adamforbes92/speedPulserPro/README.md

# SpeedPulser Pro

The SpeedPulser Pro converts a vehicle speed signal — from a gearbox hall sensor, a [Can2Cluster](https://forbes-automotive.com) signal, a CAN bus (ECU / ABS / DSG / UDS), or a GPS module — into a 10 kHz PWM signal that drives a BLDC motor and gives life back to an OEM analog speedometer without a mechanical cable. It can also read engine RPM (hall or CAN) and re-output it as a traditional coil-style ignition signal for a tachometer. It is fully open-source, WiFi-configurable, and calibrated per cluster type so the needle reads accurately across the available speed range of the motor.

It is based on an **ESP32 DevKit V1 (WROOM-32)** and uses a **TY3816B** BLDC motor driven via a native LEDC hardware PWM channel. The PCB is an upgrade for the original SpeedPulser board, with the addition of CAN, GPS and a coil-type RPM output.

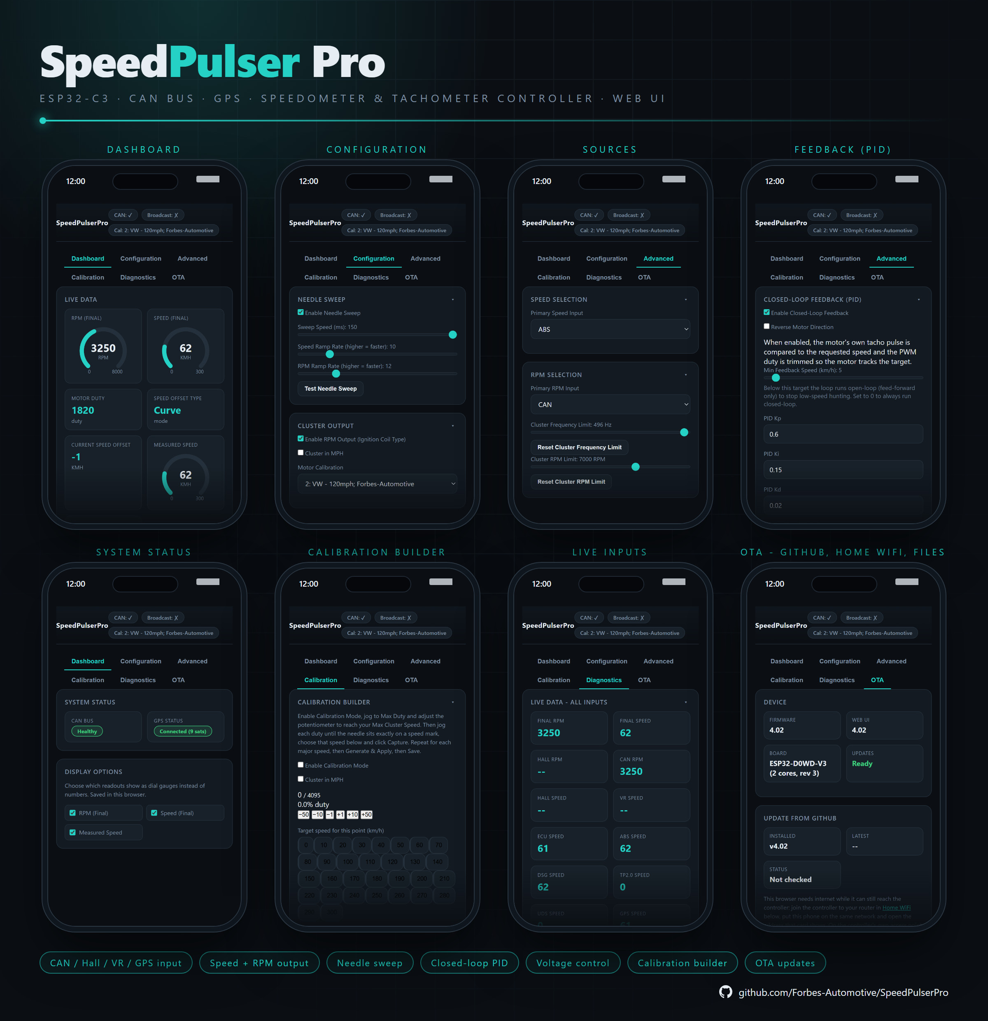
[picture p1: Images/speedPulserProUI.png]
SpeedPulser Pro Web UI — Dashboard, Configuration, Advanced Inputs, Calibration and Diagnostics


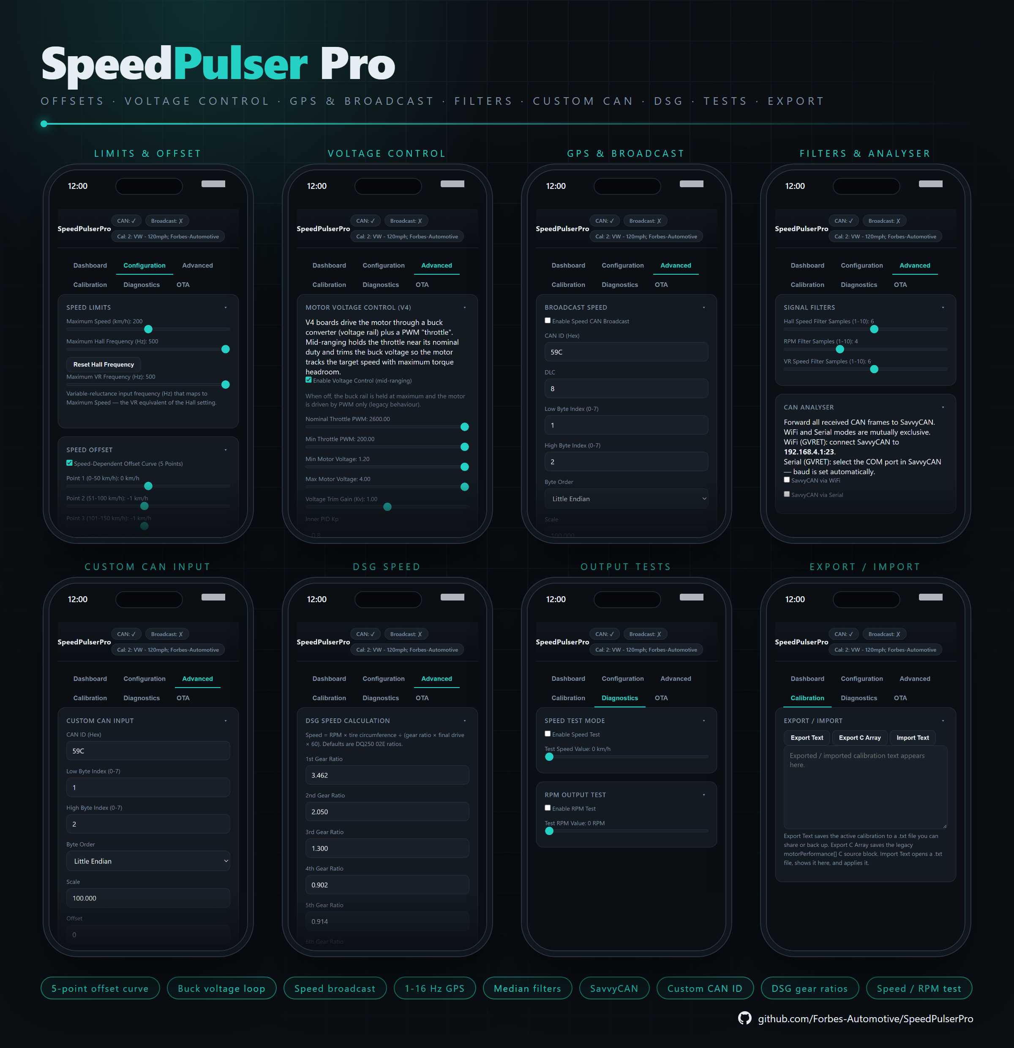
[picture p2: Images/speedPulserProUI-2.png]
SpeedPulser Pro Web UI — limits & offset, voltage control, GPS & broadcast, filters & analyser, custom CAN, DSG speed, output tests and export / import


---

## Features at a Glance

| Feature | Detail |
|---|---|
| Speed input | Hall, ECU (CAN), ABS (CAN), DSG (TP2.0), UDS (CAN), GPS, Custom CAN |
| RPM input | Hall (12 V square wave) or CAN |
| Speedometer output | 10 kHz hardware PWM, 10-bit resolution |
| RPM output | Coil-style square wave (hardware-timer driven) |
| CAN | 500 kbit/s TWAI, full RX/TX, broadcast & SavvyCAN forwarding |
| GPS | u-blox NMEA, 1 / 5 / 10 / 16 Hz user-selectable update rate |
| Calibration profiles | 18 built-in (VW, Ford, Fiat, Merc, Smiths, Opel, VW Bay) |
| Calibration Builder | Custom calibration builder - no coding knowledge required |
| Calibration Curve | Live duty-vs-speed curve with the current operating point on the Dashboard |
| PID Control | Uses the Feedback pin on the motor to ensure speed is maintained, regardless of 'stickyness' |
| WiFi UI | Web app type interface |
| Needle sweep | Full-scale exercise of both needles on power-up (speed + RPM), live-adjustable sweep speed |
| Speed offset | Global fixed offset **or** 5-point speed-dependent curve |
| OTA updates | Update from GitHub or by file upload on the OTA tab; Home Wi‑Fi bridge mode; recovery page if the web UI is ever lost |
| CAN analyzer | Forward live frames to SavvyCAN via WiFi (GVRET) or Serial |
| Power management | Auto WiFi-off + CPU scaling after 1 min idle |
| Remembers settings | All settings stored to ESP32 Preferences (EEPROM) |

---

## Supported Models

| Cluster | Range | Calibration by |
|---|---|---|
| VW MK1 / MK2 Golf | 120 mph | Martin Springell |
| VW MK1 / MK2 Golf | 120 mph | Forbes Automotive |
| VW MK1 / MK2 Golf | 120 mph | Tara |
| VW MK1 / MK2 Golf | 140 mph | Forbes Automotive |
| VW MK1 / MK2 Golf | 160 mph | Forbes Automotive |
| VW MK1 / MK2 Golf | 300 kph (1.8T) | Forbes Automotive |
| VW Bay VDO | 90 mph | Community |
| Ford Escort | 120 mph (var. 1) | Forbes Automotive |
| Ford Escort | 120 mph (var. 2 — Darren) | Community |
| FIAT Uno | 40–160 mph | Forbes Automotive |
| FIAT Uno | 20–110 mph | Forbes Automotive |
| Mercedes W123 | 120 mph | Forbes Automotive |
| Smiths 5/8" | 70 mph | Forbes Automotive |
| Smiths 5/8" | 90 mph | Forbes Automotive |
| Smiths 5/8" | 150 mph | Forbes Automotive |
| Opel Manta A-72 | 200 km/h | Forbes Automotive |

> Users are actively encouraged to submit new models, calibrations, or corrections via GitHub or Discord.

---

## Purchase

Pre-assembled SpeedPulser Pro units are available here: [SpeedPulser Pro — Forbes Automotive](https://forbes-automotive.com/products/speedpulserpro)

---

## More Detailed Instructions

The PDF Installation Guide on GitHub provides full step-by-step hardware fitting instructions.

---

## Hardware Overview

### PCB

The pre-assembled PCB carries three plug-in connectors along its edge plus a 4-pin GPS header:

- **Power / RPM Output** — 3-pin (silkscreen `12v GND MK2RPM`)
- **Motor** — 5-pin (silkscreen `MOTOR`)
- **Inputs / CAN** — 4-pin (silkscreen `RPM Speed CANH CANL`)
- **GPS** — 4-pin pin header (below ESP32)

---

### Power Supply & RPM Output Connector

The three-pin **`12v GND MK2RPM`** connector accepts 12 V battery power and provides the coil-style RPM tach output:

| Pin | Signal | Notes |
|-----|---|---|
| 1 | MK2 RPM Out | Closest to edge of PCB — high-voltage RPM output to the tach |
| 2 | GND | Common ground |
| 3 | PWR_IN (12 V) | Closest to the 5-pin motor connector; connect to ignition-switched 12 V |

> **Note:** The RPM output is intended for clusters expecting a coil-style square wave (e.g. VW MK2 tachometer). Enable it from the **Configuration** tab via the *Use Coil Output (RPM)* checkbox.

> **Legacy clusters & needle jitter:** On some older cluster, the coil-style RPM output can induce a little jitter in the hall inputs due to poor grounding. Fitting a **~500 Ω resistor in series** with the RPM output largely reduces this.

An on-board adjustable **LM2596S** buck converter steps the 12 V supply down to approximately 9 V to power the motor, keeping the motor's operating range and torque within spec across the full speed scale.

---

### Motor Connector

The five-pin **`MOTOR`** connector on the PCB:

| Pin | Signal | Notes |
|-----|---|---|
| 1 | Motor Power | Black — 5–9 V (set via on-board trimmer) |
| 2 | Motor Feedback | For PID Control |
| 3 | Motor Direction | Green — pull to GND to reverse needle direction |
| 4 | Motor Ground | White — motor ground |
| 5 | Motor PWM | 10 kHz PWM from ESP32 (via NPN level-shifter to 4V) |

---

### Inputs / CAN Connector

The four-pin **`RPM Speed CANH CANL`** connector carries both square-wave inputs and the CAN bus:

| Pin | Signal | Notes |
|-----|---|---|
| 1 | RPM In | 12V square-wave RPM input (closest to the blue trimmer) |
| 2 | Speed In | 5V or 12V square-wave speed input (hall sensor or Can2Cluster) |
| 3 | CAN H | CAN bus high |
| 4 | CAN L | CAN bus low (closest to the 5-pin motor connector) |

> **Pull-up / Pull-down jumper:** Different hall sensors require either a pull-up or pull-down resistor. The 2-way jumper marked *SpeedPulser* selects this. If incoming pulses aren't being registered, swap the jumper position. Sensors with an internal resistor can have the jumper removed entirely.

> **CAN termination (`r-term`):** A 120 Ω terminating resistor for the CAN bus is selected by the `r-term` jumper. Leave it fitted if the SpeedPulser Pro is the only device on the bus. Remove it if the bus is already terminated elsewhere.

---

### GPS Connector

The four-pin GPS header accepts any 3.3 V u-blox-compatible NMEA module (e.g. NEO-6M / NEO-M8N):

| Pin | Signal | Notes |
|-----|---|---|
| 1 | 3.3 V | Powered from the ESP32 on-board 3.3 V rail |
| 2 | RX | GPS RX — connect to GPS module TX |
| 3 | TX | GPS TX — connect to GPS module RX |
| 4 | GND | Ground |

The GPS is driven via the ESP32 hardware UART for clean reception at high update rates.

---

### Coupler Installation

Motors are supplied with the coupler pre-fitted; the final drive pin and securing pins are included separately.

1. Remove the motor from the coupler housing.
2. Align the drive pin into the coupler recess and press home — a few light taps should seat it fully.
3. A spare coupler is supplied. Couplers are 3D printed; slight alignment variation is normal. A brief gentle heat application (≤ 100 °C) can encourage a true run.
4. If excessive vibration causes the coupler to loosen, a small drop of super-glue will fix it permanently — confirm it runs true before the glue sets.

---

### Trimming the Drive Shaft

Drive shafts are supplied longer than required. Trim to suit your cluster, typically flush with the motor housing. **Confirm the shaft does not bottom out in the cluster before tightening.**

---

### Fine-Tuning the Coupler

Once the motor is assembled, slide it over the OEM cluster shaft. Check:

- The drive pin engages cleanly
- The motor spins freely by hand
- The pin length is sufficient to engage the cluster but does not prevent the housing from seating fully

Take time here — good fitment minimises noise and extends coupler life.

> Couplers are 3D printed and every motor / housing / cluster pairing wears in slightly differently. Expect to revisit the on-board potentiometer once after a few hours of running so the top-end reading still hits full-scale cleanly.

---

## WiFi & Web Interface

Connect to the **`SpeedPulserPro`** WiFi access point (open network) and navigate to **`192.168.1.1`** or **`speedpulserpro.local`** in a browser.

The interface is a single-page app served from the ESP32's LittleFS flash partition, built on Forbes Automotive's shared dark theme (the same look and status-colour conventions used across OpenHaldex, Can2Cluster, SpeedPulser, can2rpm, the MQB Steering Wheel Controller and AirLift Controller). Settings are applied in real time and saved to EEPROM automatically every 5 seconds. Current firmware version: **5.04**.

**Status colours**, used throughout the Dashboard and Diagnostics tabs:

| Colour | Meaning |
|---|---|
| 🟢 Green | Healthy / connected — CAN traffic present, GPS has a satellite fix, feedback signal detected |
| 🔴 Red | Unhealthy / missing — no CAN traffic, or no GPS module fitted/connected |
| 🟠 Orange | A caveat, not a failure — GPS module is talking but has no satellite fix yet ("Connected (no sats)"), a gauge is showing a **Test Mode** value instead of a real sensor reading, or closed-loop feedback has no motor tacho signal ("N/A" on legacy PCBs) |

### Dashboard Tab

<p align="center">
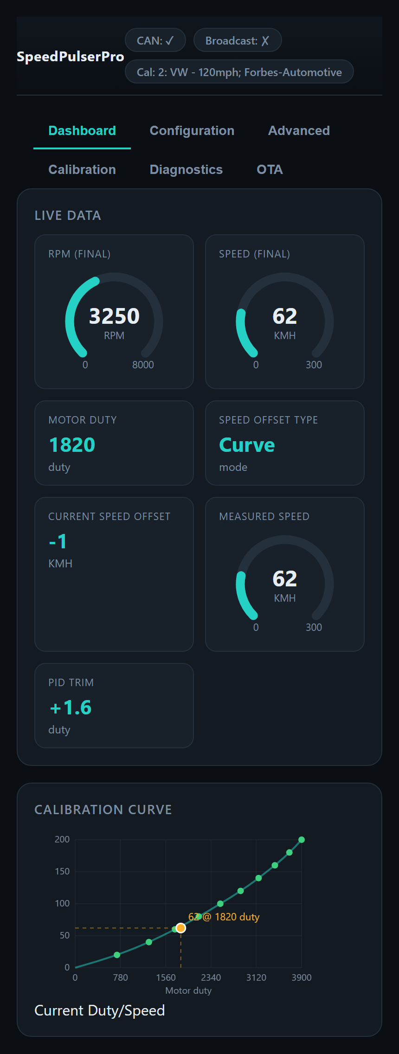
[picture p3: Images/ui-dashboard.png]
Dashboard tab — live data tiles and the calibration curve graph
  
  &nbsp;&nbsp;
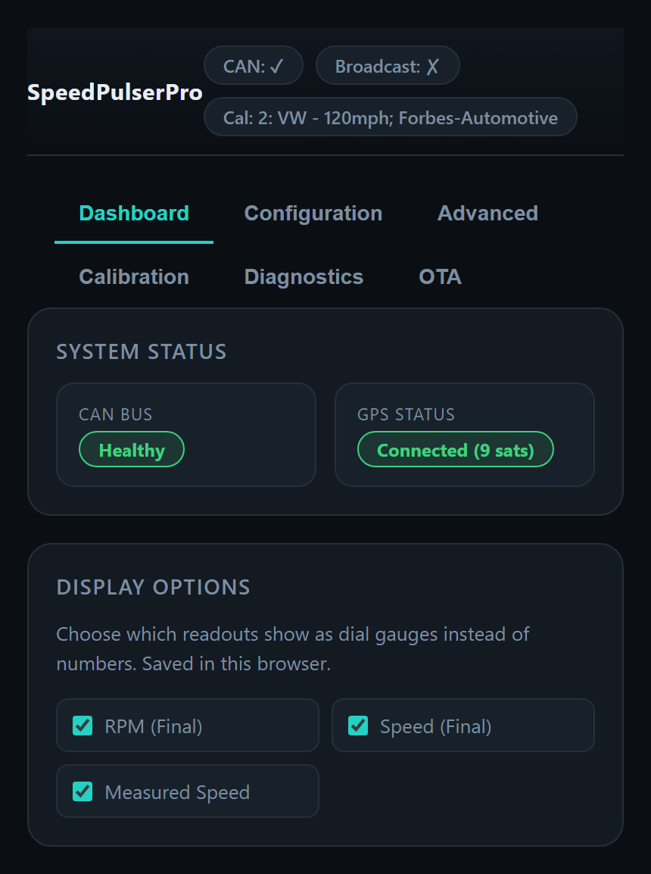
[picture p4: Images/ui-system-status.png]
Dashboard tab — system status pills (CAN, GPS, feedback) and display options
  
</p>

Live read-outs updated automatically:

| Field | Description |
|---|---|
| RPM (Final) | Engine RPM from the active RPM source |
| Speed (Final) | Vehicle speed from the active speed source |
| Motor Duty | PWM duty currently applied to the motor |
| Speed Offset Type | Whether a *Global* or *Curve* offset is active |
| Current Speed Offset | The offset value applied at the current speed |
| Measured Speed | Speed derived from the motor feedback when feedback is enabled |
| PID Trim | Duty correction the feedback loop is currently applying |
| CAN Bus | Live CAN healthy / Not Healthy indicator |
| GPS Status | **Connected (n sats)**, **Not Connected** (module fitted, no serial/fix) or **Not Available** (no GPS module fitted) |

Below the gauges is a **Calibration Curve** graph: a duty-vs-speed trace of the
active calibration with a marker showing the point currently being achieved —
from the active speed source, Speed Test Mode or Calibration Mode.

Header status badges also show **CAN**, **Broadcast** and the active **Calibration** profile.

### Configuration Tab

<p align="center">
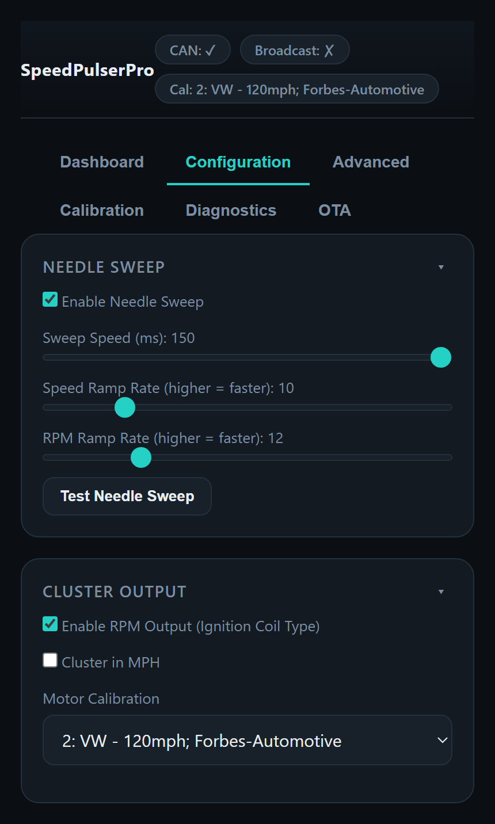
[picture p5: Images/ui-configuration.png]
Configuration tab — needle sweep and cluster output cards
  
  &nbsp;&nbsp;
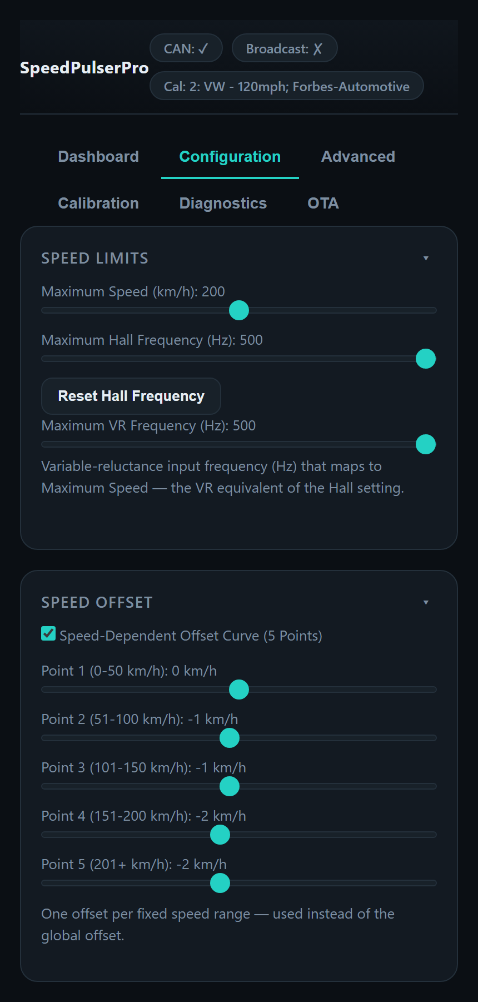
[picture p6: Images/ui-speed-limits.png]
Configuration tab — speed limits (max speed, hall and VR frequency) and the speed offset card with the 5-point curve
  
</p>

| Card | Setting | Description |
|---|---|---|
| **Needle Sweep** | Enable Needle Sweep | Run a full-scale sweep of both needles on power-up |
| | Sweep Speed (ms) | Live slider (0–50) setting the base sweep duration — lower = faster |
| | Speed Ramp Rate | How fast the speedo needle ramps (higher = faster) |
| | RPM Ramp Rate | How fast the tacho needle ramps (higher = faster) |
| | Test Needle Sweep | Trigger a sweep immediately from the browser |
| **Cluster Output** | Use Coil Output (RPM) | Enable the coil-style RPM output on the `MK2RPM` pin |
| **Speed Limits** | Cluster in MPH | Convert the km/h source value to mph before the motor-duty lookup |
| | Motor Calibration | Choose from the built-in cluster calibration profiles |
| | Maximum Speed (km/h) | Upper end of the cluster's speed scale |
| | Maximum Hall Frequency (Hz) | Input frequency that corresponds to Maximum Speed |
| **Speed Offset** | Enable Global Speed Offset | Apply a single fixed offset across the whole range |
| | Positive Offset | Direction of the fixed offset (add or subtract) |
| | Global Speed Offset | Magnitude of the fixed offset |
| | Speed-Dependent Offset Curve | Switch to the 5-point curve (see the Calibration tab) instead of the global offset |

### Advanced Tab

Source selection, tuning and diagnostics:

<p align="center">
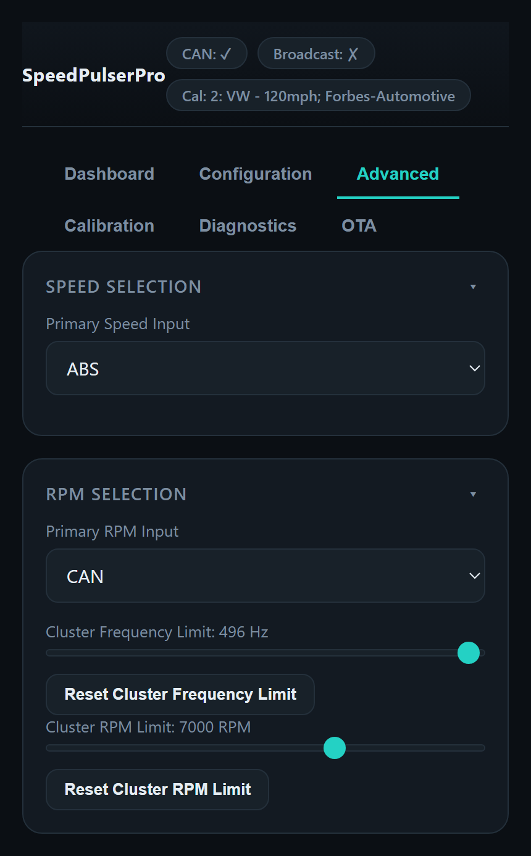
[picture p7: Images/ui-advanced.png]
Advanced tab — speed and RPM source selection
  
  &nbsp;&nbsp;
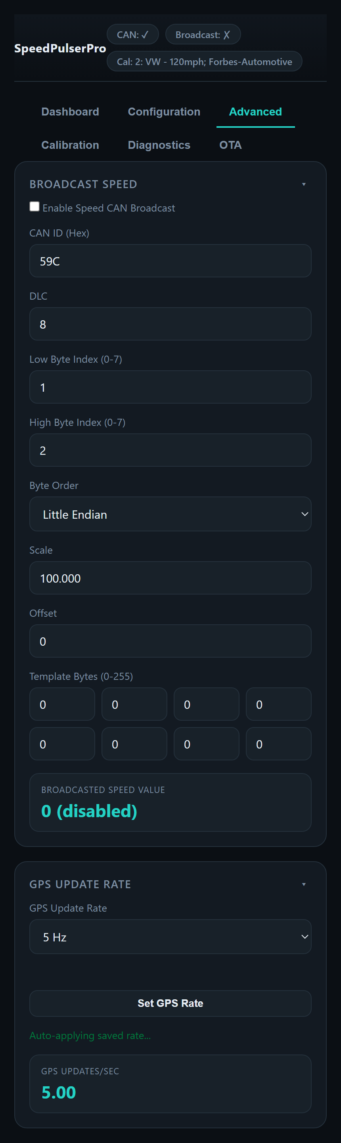
[picture p8: Images/ui-gps.png]
Advanced tab — Broadcast Speed (CAN ID, DLC, byte layout, scale, template bytes) and GPS Update Rate
  
</p>

| Card | Purpose |
|---|---|
| Closed-Loop Feedback (PID) | Enable motor feedback and tune Kp / Ki / Kd |
| Motor Voltage Control (V4) | On V4 boards, enable the mid-ranging buck-voltage loop and set its throttle PWM range, voltage range, trim gain and loop gains |
| Broadcast Speed | Send the final speed onto CAN with user-defined ID, DLC, byte layout, scale & offset bytes |
| GPS Update Rate | Select **1 / 5 / 10 / 16 Hz** and view the live updates-per-second figure |
| Signal Filters | Hall speed, VR speed and RPM running-median sample counts (1–10) |
| CAN Analyser | Forward all received CAN frames to **SavvyCAN** via WiFi (GVRET on `192.168.4.1:23`) or Serial (GVRET) |
| Speed Selection | Primary speed source: Hall / VR (S3) / ECU / ABS / DSG / TP2.0 / UDS / GPS / Custom CAN. Only one is used at a time |
| Custom CAN Input | When *Custom CAN* is selected, define ID, byte indices, endianness, scale & offset |
| DSG Speed Calculation | When *DSG* is selected, the gear ratios, final drives and tyre circumference used to derive speed from RPM and gear |
| RPM Selection | Primary RPM source (Hall or CAN), cluster frequency limit and RPM ceiling |

<p align="center">
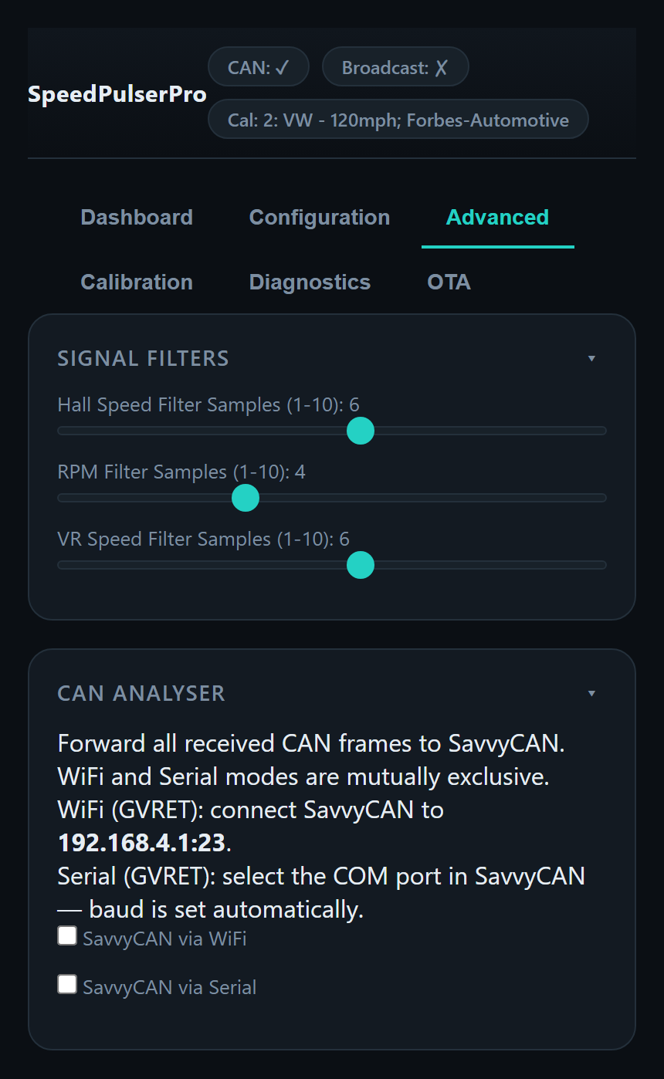
[picture p9: Images/ui-filters-analyser.png]
Advanced tab — Signal Filters (hall, RPM and VR sample counts) and the CAN Analyser SavvyCAN toggles
  
  &nbsp;&nbsp;
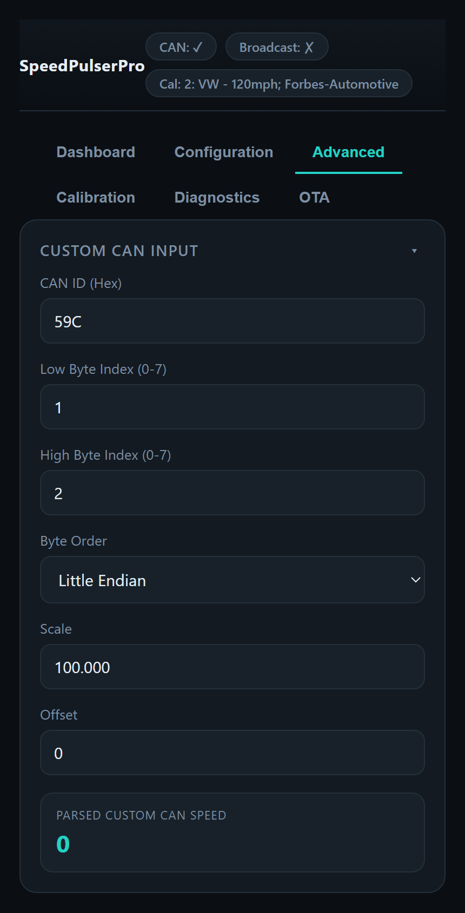
[picture p10: Images/ui-custom-can.png]
Advanced tab — Custom CAN Input: CAN ID, byte indexes, byte order, scale and offset
  
  &nbsp;&nbsp;
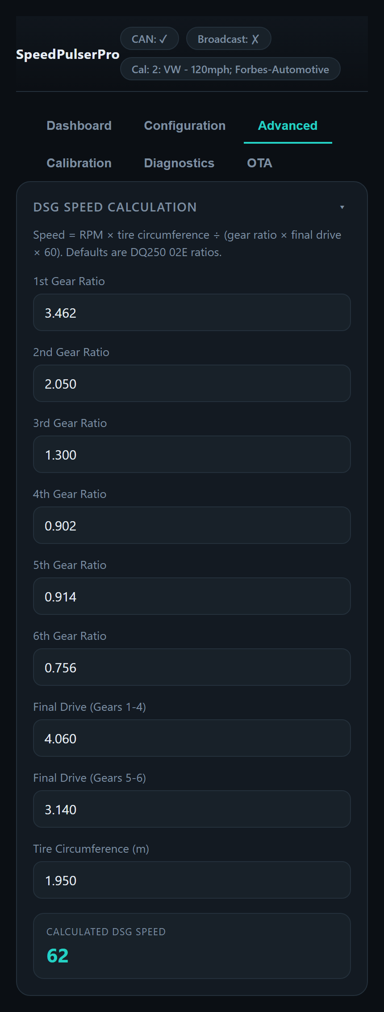
[picture p11: Images/ui-dsg-speed.png]
Advanced tab — DSG Speed Calculation: gear ratios, final drives and tyre circumference
  
</p>

*Advanced: the source selectors (top left), speed broadcast and GPS rate (top right); the filter and analyser cards, and the two cards that appear when Custom CAN or DSG is chosen as the speed source (bottom row).*

#### Closed-Loop Feedback (PID) & Reverse Direction

<p align="center">
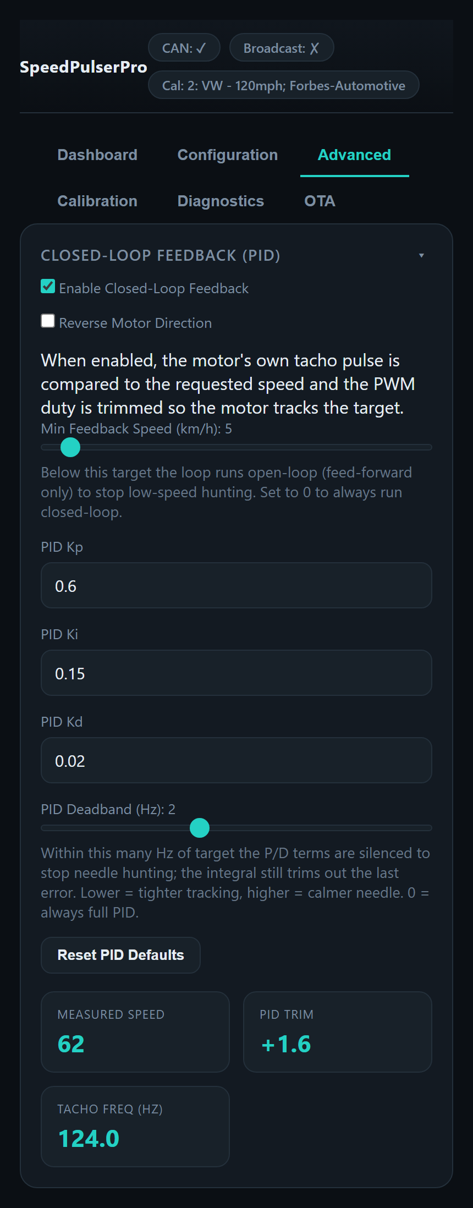
[picture p12: Images/ui-feedback-pid.png]
Advanced tab — Closed-Loop Feedback (PID): enable, reverse direction, min feedback speed, gains and live read-outs
  
  &nbsp;&nbsp;
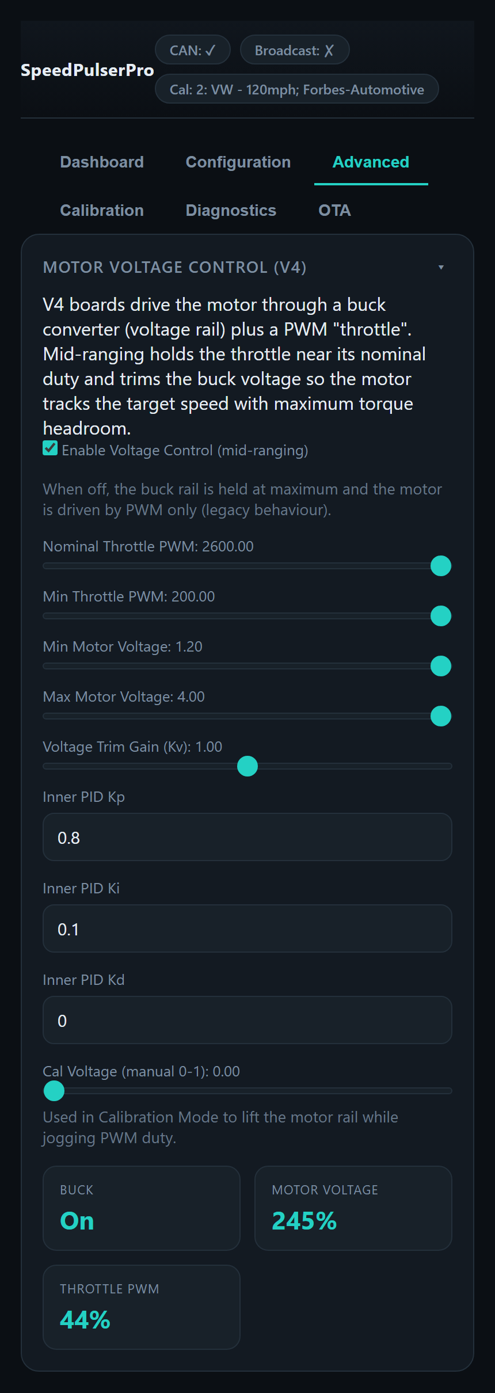
[picture p13: Images/ui-voltage-control.png]
Advanced tab — Motor Voltage Control (V4): enable, nominal / min throttle PWM, min / max motor voltage, trim gain and inner PID gains
  
</p>

The TY3816B motor is normally driven **open-loop** — a calibration table maps speed to a
PWM duty. Closed-loop feedback adds a correction on top of that table: the motor's own
feedback pulse is measured, converted to an equivalent speed, and compared to the requested
speed. A PID controller then trims the duty so the needle tracks the target even as supply
voltage, temperature or coupler friction drift.

- **Enable Closed-Loop Feedback** — turns the loop on. With it off the motor runs purely
  from the calibration table (feed-forward only).
- **Reverse Motor Direction** — flips the commanded rotation for clusters (or coupler
  builds) whose needle sweeps the opposite way. Toggle it if the needle drives backwards
  off the stop.
- **Min Feedback Speed (km/h)** — below this target the loop runs open-loop (feed-forward
  only) to stop low-speed hunting around the motor's dead band. Set to `0` to always run
  closed-loop. 
- **PID Kp / Ki / Kd** — proportional, integral and derivative gains. The defaults
  (`Kp 0.15`, `Ki 1.3`, `Kd 0`) suit the stock motor; *Reset PID Defaults* restores them.
- **Live read-outs** — *Measured Speed*, *PID Trim* (the duty correction currently being
  applied) and *Tacho Freq (Hz)* let you watch the loop settle in real time.

> Feedback is most useful at the top of the scale, where a small voltage sag would
> otherwise leave the needle a few km/h low. Leave *Min Feedback Speed* around 40 km/h so
> the loop only engages once the motor is comfortably out of its dead-band.

**Motor Voltage Control (V4 boards)** — V4 PCBs drive the motor through a buck converter
(voltage rail) as well as the PWM "throttle". With **Enable Voltage Control (mid-ranging)**
on, the fast loop above trims the throttle PWM to hit the target speed while a slow loop
nudges the buck voltage to hold the throttle near its **Nominal Throttle PWM**, keeping
maximum torque headroom. Turn it off and the rail is held at maximum with PWM-only drive
(legacy behaviour).

### Calibration Tab

<p align="center">
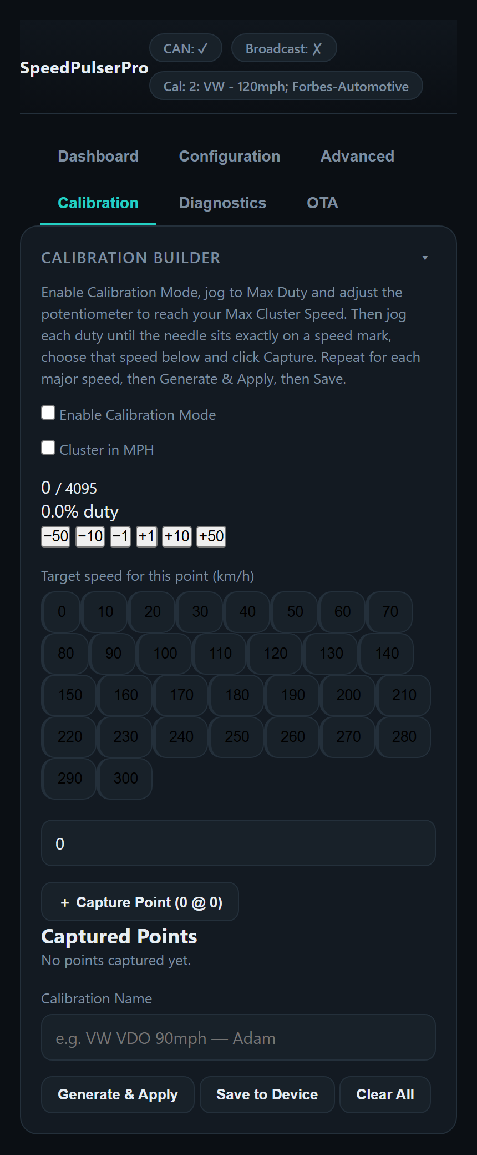
[picture p14: Images/ui-calibration.png]
Calibration tab — the Calibration Builder: calibration mode, duty jog buttons, target speed, capture point, name, Generate & Apply, Save to Device
  
  &nbsp;&nbsp;
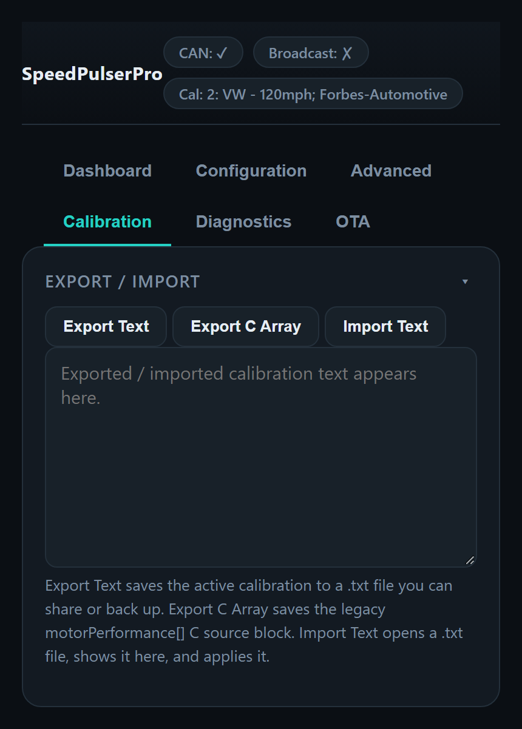
[picture p15: Images/ui-export-import.png]
Calibration tab — Export Text, Export C Array and Import Text
  
</p>

| Card | Purpose |
|---|---|
| Calibration Builder | Build a cluster calibration interactively — change the motor duty, capture a point at each speed, and store the resulting curve without editing source code |
| Export / Import | Export the active calibration to a text block, or upload one to load it |

The **Calibration Builder** is the no-code way to build a custom calibration on the bench.  The other advantage is that it uses a higher range of available duty so available scale is increased.

1. Tick **Enable Calibration Mode** — the motor now follows the big duty read-out instead
   of the speed source.
2. Change the duty to the maximum value (**4096**).  Adjust the trimmer to achieve maximum cluster value.
3. Change the duty with the **−50 / −10 / −1 / +1 / +10 / +50** buttons until the needle sits exactly on a speed mark.
4. Pick that speed from the **Target speed** or type it in and press **Capture Point**. Each capture
   is listed under *Captured Points* and can be removed individually.
5. Repeat across the scale, name the calibration, then **Generate & Apply** to preview it
   live and **Save to Device** to store it. **Export / Import** shares it as a text block.

The **5-Point Speed Offset Curve** is switched on from the *Speed Offset* card on the
Configuration tab. It applies a different trim per speed band instead of a single global
value. Bands are fixed at 0–50 / 51–100 / 101–150 / 151–200 / 201+ km/h, each accepting
±20 km/h.

### Diagnostics Tab

<p align="center">
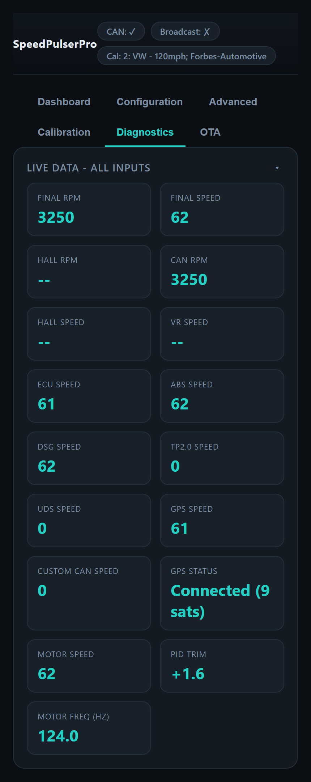
[picture p16: Images/ui-diagnostics.png]
Diagnostics tab — Live Data: every speed and RPM input read separately
  
  &nbsp;&nbsp;
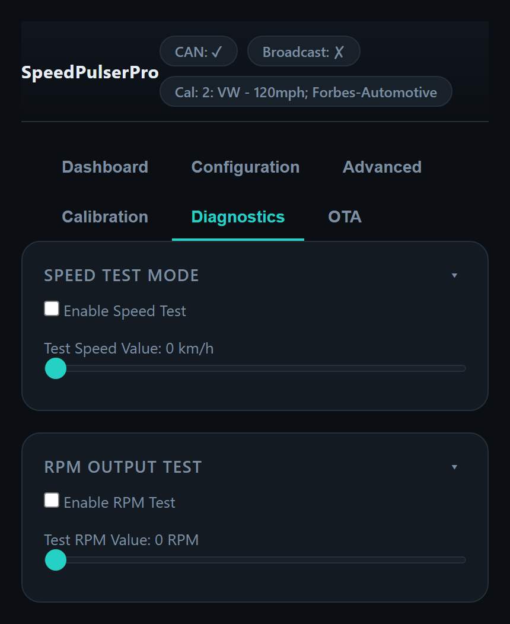
[picture p17: Images/ui-output-tests.png]
Diagnostics tab — Speed Test Mode and RPM Output Test sliders
  
</p>

| Card | Purpose |
|---|---|
| Live Data – All Inputs | Independent read-out for every speed/RPM source (Hall, ECU, ABS, DSG, TP2.0, UDS, GPS, Custom CAN, plus filtered RPM) |
| Speed Test Mode | Drive the speedometer directly to a chosen speed with a slider |
| RPM Output Test | Drive the tachometer directly to a chosen RPM with a slider |

## GPS & Update Rates

The GPS module is driven via the ESP32 hardware UART for reliable reception. SpeedPulser Pro supports user-selectable update rates of **1 Hz, 5 Hz, 10 Hz and 16 Hz**, sent to the module as u-blox UBX rate commands. The selected rate is stored in EEPROM and survives reboots.

### How It Works

1. On boot, the firmware probes the GPS at 9600 baud and 38400 baud and locks onto whichever yields valid checksum-passing NMEA. The u-blox module always boots at 9600, so a re-flash without power-cycling the GPS is handled cleanly.
2. The GPS is left at its boot baud (9600) until satellite lock is acquired.
3. Once satellites are stable for ~20 seconds, the firmware automatically applies the stored update rate. If a rate of 5 Hz or higher is requested, it first issues a `PUBX,41` command to step the module up to 38400 baud (1 Hz uses 9600).
4. The user can also force the rate at any time from the **GPS Update Rate** card on the Advanced tab; the live *GPS Updates/sec* counter confirms what's actually arriving.

### Choosing a Rate

| Rate | When to use |
|---|---|
| 1 Hz | Default; lowest UART load; suitable for casual / cruise display |
| 5 Hz | Smoother needle response in normal driving |
| 10 Hz | Track / spirited driving; very responsive |
| 16 Hz | Maximum responsiveness; some u-blox modules require 38400 baud |

> The update-rate change is blocking on the UART, so the main loop briefly suspends background tasks while the PUBX command is sent — this prevents the CAN RX, speed ISR and AsyncTCP tasks from corrupting the outgoing serial bytes.

---

## Power Management

The firmware includes a **universal reduced-power manager** (`power_manager` — also used in SpeedPulser and Can2Cluster) that activates automatically 1 minute after the last WiFi client disconnects. This cuts current through the on-board linear regulator, directly reducing its heat output — important for long ignition-on times.

**What changes when idle:**

| Action | Saving |
|---|---|
| WiFi radio off | ~80–120 mA average (single biggest saving) |
| CPU: 240 MHz → 80 MHz | Moderate reduction in active current |
| Bluetooth controller released at boot | ~60 KB RAM freed; small idle current saving |
| WiFi modem-sleep while clients are connected | Minor saving without losing connectivity |
| Reduced WiFi TX power | Adequate for in-car range; further small saving |
| Onboard LED off at boot | Tiny but persistent saving |

**Waking back up:**  
As soon as a device reconnects to the WiFi AP, full power is restored automatically — the radio comes back up, the CPU returns to 240 MHz, and the web server resumes. A power-cycle (ignition off/on) will also restore WiFi.

> The ESP32 DevKit V1 (WROOM-32) runs at 240 MHz; the power manager auto-detects this at compile time and adjusts accordingly. On ESP32-C3 / S2 variants the active clock caps at 160 MHz.

---

## Calibration — How It Works

### The Legacy Calibration Array

Each calibration profile is a **386-element `uint16_t` array** stored in flash (`PROGMEM`). The **array index** represents speed in km/h (0–385) and the **array value** is the 10-bit PWM duty cycle (0–1023) that drives the motor to produce the corresponding reading on that cluster.

```
index   0  →  duty   0   (motor off / dead band)
index  50  →  duty  ~60  (motor at ~50 km/h cluster reading)
index 120  →  duty ~130  (motor at ~120 km/h cluster reading)
  ...
index 200  →  duty ~195  (motor at full scale for a 200 km/h cluster)
```

Values near index 0 are `0` — the motor's dead band where it will not yet turn. Values plateau near the top because the cluster needle is at full deflection.

> The Calibration Builder now supports a larger duty range and finer control is now available.  Legacy speed arrays are already produced so cannot be revisited.  Building your own may yield better results!

### Signal Processing 

```
Source (Hall / ECU / ABS / DSG / TP2.0 / UDS / GPS / Custom CAN)
    │
    ▼  ISR (windowed capture) / TWAI RX / GPS parser
    Hall / VR / RPM inputs accumulate each edge interval + count, rejecting
    edges closer than half a period at that input's full scale as electrical
    noise; other sources arrive in km/h
    │
    ▼  speedControlTask  (once per loop)
    For Hall: frequency = intervals ÷ summed interval time (true average over the
    window), then map(frequency, 0, maxFreqHall, 0, maxSpeed) → km/h
    For other sources: speed already in km/h
    │
    ▼  RunningMedian filter  (averageFilterHall samples, default 6)
    Smoothed median speed value
    │
    ▼  Max Speed check
    Above Max Speed for a moment: hold the last good speed (spike);
    above it for 0.5 s: park at Max Speed
    │
    ▼  applyConfiguredSpeedOffset()
    Speed ± global offset  OR  speed ± curve offset for that band
    │
    ▼  Optional: × 0.621371  if "Cluster in MPH" is enabled
    │
    ▼  findClosestMatch()
    Scans motorPerformance[] for the closest matching speed value
    Returns the array index = 10-bit duty cycle
    At or below the array's lowest speed the motor stays off
    │
    ▼  setMotorDuty()  — native LEDC IDF driver, 10 kHz
    Motor PWM output on GPIO 21
```

> **Default hall-sensor scaling:** 1 Hz = 1 km/h. This matches 02J / 02M gearbox sensors used in most VW/Audi applications. Adjust `maxFreqHall` and `maxSpeed` together if your sensor has a different ratio (e.g. set both to 160 for a sensor that outputs 160 Hz at 160 km/h).

> **Windowed frequency capture:** The hall, VR and RPM inputs no longer derive their reading from a single edge-to-edge period — which could turn tone-wheel / tooth-spacing jitter straight into a jumpy needle. Instead each ISR accumulates the edge intervals and the task averages them once per window, and edges closer than half a period at that input's full scale (Max Hall Frequency / Max VR Frequency / Cluster Frequency Limit, never above 1 kHz) are rejected so ignition-coil EMI can't be mistaken for a valid signal.

> [!NOTE]
> **Lowest speed shown:** each legacy calibration array has a lowest speed the motor can hold (the default array starts at 24 km/h). At or below it the motor is switched off and the needle rests on zero, so low test speeds on the bench may not move the needle. On the S3 board, Voltage Control with a drive calibration that includes a low mark reaches much slower speeds.

### Reading a Legacy Calibration Array

To check what duty a profile produces at a given speed, index directly:

```cpp
// Direct lookup — returns the 10-bit duty for 80 km/h on the active profile
uint16_t duty = motorPerformance[80];
```

`findClosestMatch()` does the inverse: given a target speed value, it walks the array to find the entry whose **value** is closest to the target and returns the **index** as the duty cycle. This gracefully handles calibration arrays that are not perfectly monotone.

---

## Speed Offset

Two offset modes are available and are configured from the **Configuration** and **Calibration** tabs respectively.

**Global Offset** (default)  
A single fixed value is added to or subtracted from every speed reading before the calibration lookup. Useful for correcting a systematic bias across the whole scale caused by motor preload or cluster wear.

**5-Point Curve**  
Five independent offsets replace the global offset when enabled. This corrects clusters whose response is non-linear and cannot be fixed by a single constant.

| Point | Speed band |
|---|---|
| 1 | 0 – 50 km/h |
| 2 | 51 – 100 km/h |
| 3 | 101 – 150 km/h |
| 4 | 151 – 200 km/h |
| 5 | 201+ km/h |

Each point accepts ±20 km/h. Enable the *Speed-Dependent Offset Curve* checkbox on the Calibration tab to activate.

---

## CAN Bus

The SpeedPulser Pro runs the ESP32 TWAI controller at **500 kbit/s** with all-pass filtering, so any frame on the bus is available to the firmware.

### Built-in Decoders

| Source | Frames used | Output |
|---|---|---|
| ECU (VAG) | `MOTOR1` engine RPM, `MOTOR2` speed, `MOTOR5/6` EML/EPC/park | `vehicleRPMCAN`, `ecuSpeed` |
| ABS (VAG) | `BRAKES3` wheel-derived speed | `absSpeed` |
| DSG / Gear lever | `mWaehlhebel_1`, `gearLever` | Selected gear, reverse flag |
| DSG (TP2.0) | Channel setup → speed PID | `tp20Speed` |
| Generic | UDS read (0x22) speed PID | `udsSpeed` |
| Custom CAN | User-defined ID + byte layout | `vehicleSpeedCAN` |

Pick the source from the **Speed Selection** drop-down on the Advanced tab.

### Broadcasting Speed

The final processed speed (after offset / MPH conversion) can be re-emitted onto CAN for downstream devices (e.g. cluster mods, head units). Configure the CAN ID, DLC, low/high byte indices, endianness, scale, offset and any template bytes from the **Broadcast Speed** card.

### SavvyCAN Forwarding

Every received frame can be forwarded to **SavvyCAN** for live capture:

- **WiFi mode** — GVRET protocol on TCP port `192.168.4.1:23`.
- **Serial mode** — GVRET protocol on USB-CDC.

The two modes are mutually exclusive and can be toggled from the CAN Analyzer card.

---

### Over-the-Air Updates

Everything happens on the **OTA** tab; USB is only needed for the very first install, or if the web interface is ever lost.

- **Update from GitHub** — press **Check for updates**. The page reads the release list from [`adamforbes92/speedPulserPro`](https://github.com/adamforbes92/speedPulserPro) (`Releases/releases.json` plus the `V…` folders), shows *Installed* vs. *Latest* (older and beta releases sit behind a tick-box, for rolling back), then installs the selected version in six tracked steps: download and flash the web UI, verify it, download and flash the firmware, reboot. The browser needs internet *while it can still reach the controller* — join the controller to your router in the **Home WiFi (Bridge Mode)** card, put the phone on the same network and open the address the card shows (`http://speedpulserpro.local/` works there too). On the controller's own access point alone most phones drop mobile data.
- **Home WiFi (Bridge Mode)** — the controller joins a home or garage network as a station alongside its own access point. Scan or type the network name, save, and once it shows *Connected* the controller is reachable from that network as well. It tries hard for 20 s after boot, then once every 5 minutes, so a saved network can't disturb the access point when the car is parked away from home.
- **Update from Files** — no internet needed: download `littlefs.bin` and `firmware.bin` from the newest `Releases/V…/` folder and upload them here, **Filesystem** (web UI) first, then **Firmware**. The device reboots after the firmware.

Every upload is size-checked, and a filesystem image is verified by mounting it before the device reports success — a failed filesystem upload is wiped rather than left half-written. If the web interface is ever missing (a filesystem update that stopped part-way), the controller serves a **recovery page** at its address with the same two uploads and partition diagnostics, so it is never a USB job. Web assets are served `no-cache`, so a new UI is never hidden behind a stale copy in the phone's browser. `GET /api/ota/info` reports the firmware and web UI versions shown at the top of the tab; `GET /api/ota/check` gates updates on the device being in a safe state.

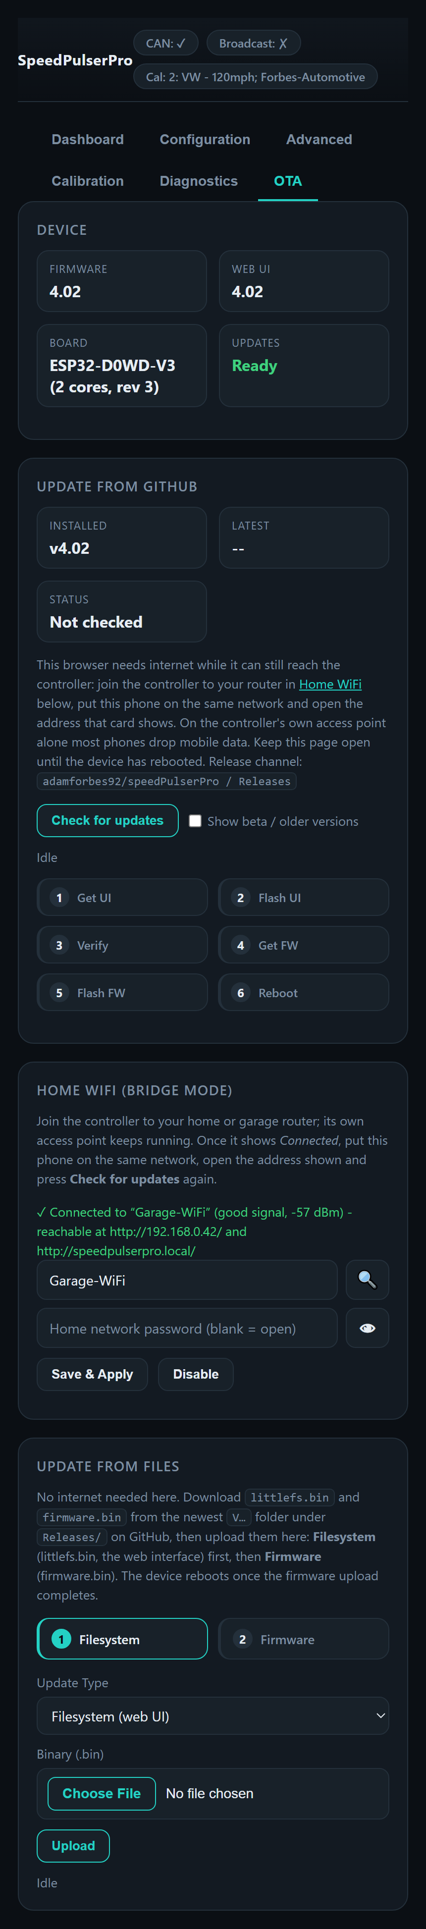
[picture p18: Images/ui-ota.png]
OTA tab — Update from GitHub, Home WiFi bridge mode and Update from Files


---

## Technical Reference

### Pin Assignments (ESP32 DevKit V1)

| GPIO | Function |
|---|---|
| 2  | Onboard LED |
| 13 | GPS TX (ESP → module RX) |
| 14 | GPS RX (ESP ← module TX) |
| 16 | TWAI / CAN TX |
| 17 | TWAI / CAN RX |
| 18 | RPM hall input (falling-edge interrupt) |
| 19 | Motor Direction |
| 21 | Motor PWM output (LEDC, stepped to 5 V via NPN transistor) |
| 22 | Coil-style RPM output (hardware timer) |
| 23 | Motor Feedback |
| 26 | Speed hall input (falling-edge interrupt) |

### PWM Parameters

| Parameter | Value |
|---|---|
| Frequency | 10 kHz |
| Resolution | 10-bit (0–1023) |
| Driver | Native ESP-IDF `ledc_set_duty` / `ledc_update_duty` |

### CAN / TWAI

| Parameter | Value |
|---|---|
| Baud | 500 kbit/s |
| Mode | Normal, accept-all filter |
| RX queue | 256 frames |
| TX queue | 16 frames |

### FreeRTOS Tasks

| Task | Purpose |
|---|---|
| `taskCANRx` | TWAI receive + decoder + SavvyCAN forwarder |
| `taskWriteEEP` | Persist Preferences (5 000 ms) |
| `taskUpdateUI` | Push live values to the web UI (200 ms) |
| `taskParseGPS` | Continuous TinyGPS++ parse |
| `taskParseDSG` | DSG / gear ratio decode |
| `taskProcessSpeed` | Hall averaging, source selection, offset, duty lookup |
| `taskProcessRPM` | RPM source selection and output drive |
| `taskBroadcastSpeed` | Periodic CAN broadcast of final speed |
| `taskTP20` / `taskUDS` | Transport-protocol speed pollers |

### PlatformIO Dependencies

| Library | Purpose |
|---|---|
| `mathieucarbou/ESPAsyncWebServer` | Async web server (ESP-IDF 5.x compatible fork) |
| `mathieucarbou/AsyncTCP` | Underlying TCP for AsyncWebServer |
| `bblanchon/ArduinoJson` | JSON serialisation for REST API |
| `RobTillaart/RunningMedian` | Median filter for speed/RPM smoothing |
| `mikalhart/TinyGPSPlus` | NMEA parsing |
| `plerup/espsoftwareserial` | Legacy software-UART fallback |

Platform: `pioarduino/platform-espressif32` 54.03.20 (Arduino-ESP32 3.x / ESP-IDF 5.x)

---

## Disclaimer

The SpeedPulser Pro drives an analog speedometer for display purposes. It should always be assumed that the reading is approximate — Forbes Automotive accepts no responsibility for any speed-related incident arising from its use.

---

## Version History

| Version | Summary |
|---|---|
| V1.01 | Initial release — used SpeedPulser and Can2Cluster as a base |
| V1.02 | Confirmed WiFi and RPM working |
| V1.03 | Board revision — EasyEDA, ground planes, separate Speed / RPM pull-to-ground inputs, ECU RPM repurposed pin |
| V1.04 | "Cannot find" speed → set to zero; low-speed fixes |
| V1.05 | Hall-type RPM in WiFi UI; on-the-fly calibration changes; read EEP at startup |
| V1.06 | New calibrations; removed `setTxPower` (caused WiFi drop on speed change) |
| V1.07 | Speed-input selection in WiFi; UI tidy-up |
| V1.08 | Calibration page |
| V2.00 | PlatformIO port; UDS support for DSG speed reading |
| V2.01 | GPS speed reading; CAN speed broadcasting; configurable & persistent GPS update rate |
| V2.10 | Linearised needle sweep; Tara 120 mph calibration |
| V2.20 | SavvyCAN analyzer; "Cluster in MPH" conversion option |
| V2.30 | RPM / speed task pacing tuned so GPS has room to update |
| V2.40 | GPS moved to hardware `HardwareSerial` UART for faster, cleaner reception |
| V2.50 | Universal power-management module (WiFi-off + CPU scaling after 1 min idle); GPS auto-baud probe on boot; GPS update-rate auto-apply after satellite stability |
| V3.00 | Closed-loop motor feedback (PID) — measures the motor tacho and trims PWM duty so the needle holds under load |
| V3.01 | Live calibration-curve graph on the Dashboard (duty-vs-speed trace + achieved-point marker); Dashboard mirrors the standard SpeedPulser (Motor Duty / Measured Speed / PID Trim) |
| V3.02 | Live Sweep Speed slider; needle sweep rewritten to drive both needles to full deflection over a bounded time with independent Speed/RPM ramp rates (drops the Linearise control); shared `ota_manager` OTA module + reworked OTA tab; three-state GPS status; Speed Test Mode moved to the Diagnostics tab |
| V3.03 | Custom calibrations now remember the cluster unit they were captured in and the device auto-enables "Cluster in MPH" whenever an MPH cal becomes the active calibration |
| V3.04 | Closed-loop feedback is sense-check for legacy PCBs without the motor-feedback circuit |
| V4.00.0 | Voltage-control hardware support (VR input) |
| V4.01.0 | Adopted Forbes Automotive's shared Ignitron dark theme, Wi‑Fi AP/mDNS manager (`speedpulserpro.local`) and the two-step `ota_manager` firmware/filesystem OTA module, common across the ESP32 product line |
| V4.02 | OTA overhaul: uploads that complete, verified filesystem updates with a recovery page, "Update from GitHub" and a Home WiFi (bridge mode) card |
| V5.00 | ESP32-S3 board (rev6): one codebase for DevKit and S3, buck voltage control with Test Board, VR speed input, switchable speed-input bias |
| V5.01 | S3 drive calibration: up to 10 captured marks set the motor drive (rail x PWM), with an optional gentle feedback trim; voltage calibration export / import |
| V5.02 | RPM input passes through to the tach 1:1 (was ~30 RPM low); fractional-Hz RPM output; glitch filter scaled per input, so 6/8-cyl RPM above 333 Hz no longer reads half; RPM Filter Samples = 1 no longer outputs 0 RPM |
| V5.03 | Picking a speed source switches the others off (Custom CAN left TP2.0 on), and the page always shows the source really in use; a speed above Max Speed for 0.5 s parks the needle at Max Speed instead of 0; the Positive Offset tick now saves across restarts |
| V5.04 | MQB DSG speed over UDS corrected (shared DSG speed code, ported from the Can2Cluster firmware reverse-engineering): reads DID `0x100A` "Vehicle speed from transmission" on the DSG's own IDs `0x7E1/0x7E9`, 16-bit little-endian signed, km/h = raw/10, replacing a placeholder (`0x0101`, /100). PQ DSG speed (TP2.0, raw/3) confirmed correct and unchanged |
