adamforbes92/speedPulserPro/Images/gpsConnector.png

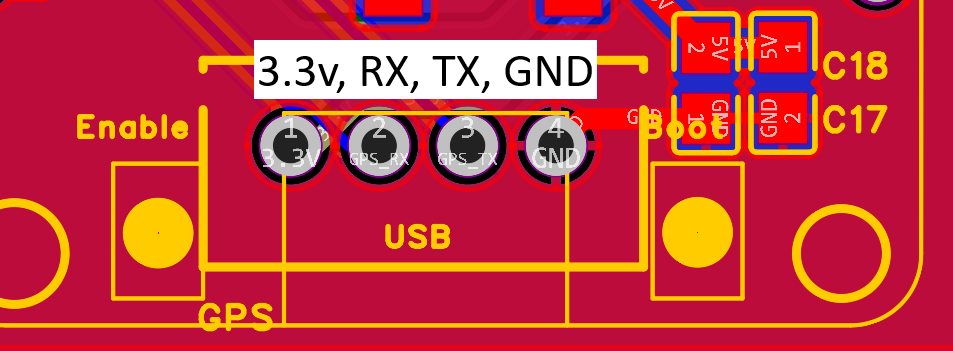
Images/gpsConnector.png
