adamforbes92/speedPulserPro/PlatformIO/include/SpeedPulserPro_config.h

#define CONFIG_H
#include "Arduino.h"
#include <WiFi.h>
#include <LittleFS.h>
#include <ESPAsyncWebServer.h>
#include "SpeedPulserPro_board.h" // SPP_BOARD_DEVKIT / SPP_BOARD_S3 + SPP_HAS_* feature flags
#define baudSerial 115200
#define enableDebug 1        // ** MASTER ** 0 = silence ALL serial debug
#define debugSys     1       // [SYS]   boot / tasks / general / 1 Hz telemetry
#define debugPower   1       // [PWR]   power_manager (WiFi-off / CPU scaling)
#define debugWifi    1       // [WiFi]  soft-AP, web server, REST, OTA, LittleFS
#define debugIO      1       // [IO]    hardware bring-up (LED / PWM / interrupts)
#define debugEEP     1       // [EEP]   Preferences read / write
#define debugCAN     1       // [CAN]   TWAI driver + chassis CAN RX
#define debugGPS     1       // [GPS]   GPS init / baud / rate / RX
#define debugSpeed   1       // [SPD]   speed processing + incoming pulses
#define debugRPM     1       // [RPM]   RPM processing + output
#define debugDSG     1       // [DSG]   DSG gear + speed
#define debugUDS     1       // [UDS]   UDS / TP2.0 diagnostic speed
#define debugSavvy   1       // [SAVVY] SavvyCAN GVRET bridge
#define debugCtrl    1       // [CTRL]  speed offset / motor calibration
#define debugFB      1       // [FB]    closed-loop feedback (PID)
#define serialDebug         (enableDebug && debugSys)
#define serialDebugIncoming (enableDebug && debugSpeed)
#define serialDebugWifi     (enableDebug && debugWifi)
#define serialDebugEEP      (enableDebug && debugEEP)
#define serialDebugGPS      (enableDebug && debugGPS)
#define ChassisCANDebug     (enableDebug && debugCAN)
#define eepRefresh 5000
#define labelRefresh 200
#define wifiDisable 60000
#define wifiHostName "SpeedPulserPro"
#define FW_VERSION "5.04"
#define incomingType 0
#define DEFAULT_AVERAGE_FILTER_HALL 6
#define DEFAULT_AVERAGE_FILTER_RPM 6
#define durationReset 1500
#define SPEED_OVER_RANGE_LOOPS 10 // speed task loops (10 x 50 ms = 0.5 s) a source must stay above Max Speed before the needle parks at Max Speed
#if SPP_BOARD_S3
#define pinMotorOutput 10       // pad 18 ESP_MOTOR      -> U11 SN74LVC1G14 -> MOTOR_OUT (PWM, LEDC)
#define pinRPMOutput 9          // pad 17 ESP_MK2RPM     -> R24 330R -> Q1 MMBT5551 (coil RPM, GPTimer toggled)
#define pinEngineRPMInput 12    // pad 20 ESP_RPM        <- U12 (ECU_RPM after R30/D8 zener/Schmitt)
#define pinGearboxHall 16       // pad 9  ESP_SPEEDPULSE <- U12 (SPEEDPULSE after R21/D6 zener/Schmitt)
#define pinRX_CAN 13            // pad 21 CAN0_RX  <- U7 TCAN1044V RXD
#define pinTX_CAN 14            // pad 22 CAN0_TX  -> U7 TCAN1044V TXD
#define pinCANStandby 21        // pad 23 CAN0_STANDBY -> U7 STB; R18 pull-down, firmware holds LOW = normal mode
#define pinRX_GPS 17            // pad 10 ESP UART RX  <- GPS_TX
#define pinTX_GPS 18            // pad 11 ESP UART TX  -> GPS_RX
#define pinMotorFeedback 8      // pad 12 ESP_MOTFEEDBACK <- U9 (MOTOR_FEEDBACK after R20/D4 zener/Schmitt)
#define pinMotorDirection 11    // pad 19 ESP_MOTOR_DIR   -> R26 -> Q2 2N7002 -> MOTOR_DIR (HIGH = reverse)
#define pinBoardVersion 7       // pad 7 BOARD_ID: R12 1k to GND -> reads LOW with INPUT_PULLUP (sanity check only)
#define pinVoltageAdjust 6      // pad 6 V_ADJ PWM "DAC" -> R32 1k/C38 1uF -> R9 1k -> R8 10k -> U5 FB (inverse)
#define pinBuckEnable 5         // pad 5 EN_ADJ -> U5 TPS62933 EN (HIGH = motor supply on; R7 holds it LOW at reset)
#define pinMotorRailSense 4     // pad 4 V_MOT_SENSE: 9V rail via R33 39k / R34 10k + C39 100nF -> ADC1_CH3
#define pinVRInput 15           // pad 8 VR_COUT, one clean edge per zero crossing, counted like the hall input
#define pinSpeedPullUp 47       // pad 24 ESP_SPD_PU -> Q4 BSS138 -> Q3 MMBT5401: R19 4.7k from VCC (12 V) onto SPEEDPULSE
#define pinSpeedPullDown 48     // pad 25 ESP_SPD_PD -> Q5 BSS138:                R46 4.7k from SPEEDPULSE to GND
#define pinOnboardLED 38        // pad 31 ESP_LED -> R41 330R -> LED -> GND (active HIGH); the module has no LED
#else
#define pinMotorOutput 21       // Motor Output (PWM)
#define pinRPMOutput 22         // RPM Output
#define pinEngineRPMInput 18    // Engine RPM Input (hall)
#define pinGearboxHall 26       // Gearbox Hall Input
#define pinRX_CAN 17 // Chassis CAN RX
#define pinTX_CAN 16 // Chassis CAN TX
#define pinRX_GPS 14 // GPS RX
#define pinTX_GPS 13 // GPS TX
#define pinMotorFeedback 23     // Motor Feedback Input
#define pinMotorDirection 19    // Motor Direction (HIGH = reverse)
#define pinCoolantUD 4          // Coolant Resistance (U/D — up/down direction)
#define pinCoolantINC 5         // Coolant Resistance (INC — increment clock)
#define pinCoolantCS 12         // Coolant Resistance (CS — chip select)
#define pinOnboardLED 2 // onboard LED
#endif // SPP_BOARD_S3
#define baudGPS 9600 // default low baud rate for Neo-6M GPS module (can be raised to 115200 after init)
#define speedMultiplier 1
#define mphFactor 0.621371
#define PI
#define LEVER_P 0x8
#define LEVER_R 0x7
#define LEVER_N 0x6
#define LEVER_D 0x5
#define LEVER_S 0xC
#define LEVER_TIPTRONIC_ON 0xE
#define LEVER_TIPTRONIC_UP 0xA
#define LEVER_TIPTRONIC_DOWN 0xB
#define gearPause 20
#define rpmPause 50
#define dsgGearSettleMs 300       // hold last DSG speed for this long after a gear change (real road speed barely moves during a shift)
#define dsgSpeedSmoothing 0.35    // low-pass factor 0..1 (1 = no smoothing) applied to DSG speed to remove residual RPM jitter
#define MOTOR1_ID 0x280
#define MOTOR2_ID 0x288
#define MOTOR3_ID 0x380
#define MOTOR5_ID 0x480
#define MOTOR6_ID 0x488
#define MOTOR7_ID 0x588
#define MOTOR_FLEX_ID 0x580
#define GRA_ID 0x38A
#define gear_ID 0x440
#define BRAKES1_ID 0x1A0
#define BRAKES2_ID 0x2A0
#define BRAKES3_ID 0x4A0
#define BRAKES5_ID 0x5A0
#define gearLever_ID 0x448
#define mWaehlhebel_1_ID 0x540
#define HALDEX_ID 0x2C0
#define emeraldECU1_ID 0x1000
#define emeraldECU2_ID 0x1001
#if enableDebug && debugSys
#define DEBUG(x, ...)  Serial.printf("[SYS] " x "\n", ##__VA_ARGS__)
#define DEBUG_(x, ...) Serial.printf("[SYS] " x, ##__VA_ARGS__)
#else
#define DEBUG(x, ...)
#define DEBUG_(x, ...)
#endif
#if enableDebug && debugPower
#define DEBUG_PWR(x, ...)  Serial.printf("[PWR] " x "\n", ##__VA_ARGS__)
#define DEBUG_PWR_(x, ...) Serial.printf("[PWR] " x, ##__VA_ARGS__)
#else
#define DEBUG_PWR(x, ...)
#define DEBUG_PWR_(x, ...)
#endif
#if enableDebug && debugWifi
#define DEBUG_WIFI(x, ...)  Serial.printf("[WiFi] " x "\n", ##__VA_ARGS__)
#define DEBUG_WIFI_(x, ...) Serial.printf("[WiFi] " x, ##__VA_ARGS__)
#else
#define DEBUG_WIFI(x, ...)
#define DEBUG_WIFI_(x, ...)
#endif
#if enableDebug && debugIO
#define DEBUG_IO(x, ...)  Serial.printf("[IO] " x "\n", ##__VA_ARGS__)
#define DEBUG_IO_(x, ...) Serial.printf("[IO] " x, ##__VA_ARGS__)
#else
#define DEBUG_IO(x, ...)
#define DEBUG_IO_(x, ...)
#endif
#if enableDebug && debugEEP
#define DEBUG_EEP(x, ...)  Serial.printf("[EEP] " x "\n", ##__VA_ARGS__)
#define DEBUG_EEP_(x, ...) Serial.printf("[EEP] " x, ##__VA_ARGS__)
#else
#define DEBUG_EEP(x, ...)
#define DEBUG_EEP_(x, ...)
#endif
#if enableDebug && debugCAN
#define DEBUG_CAN(x, ...)  Serial.printf("[CAN] " x "\n", ##__VA_ARGS__)
#define DEBUG_CAN_(x, ...) Serial.printf("[CAN] " x, ##__VA_ARGS__)
#else
#define DEBUG_CAN(x, ...)
#define DEBUG_CAN_(x, ...)
#endif
#if enableDebug && debugGPS
#define DEBUG_GPS(x, ...)  Serial.printf("[GPS] " x "\n", ##__VA_ARGS__)
#define DEBUG_GPS_(x, ...) Serial.printf("[GPS] " x, ##__VA_ARGS__)
#else
#define DEBUG_GPS(x, ...)
#define DEBUG_GPS_(x, ...)
#endif
#if enableDebug && debugSpeed
#define DEBUG_SPD(x, ...)  Serial.printf("[SPD] " x "\n", ##__VA_ARGS__)
#define DEBUG_SPD_(x, ...) Serial.printf("[SPD] " x, ##__VA_ARGS__)
#else
#define DEBUG_SPD(x, ...)
#define DEBUG_SPD_(x, ...)
#endif
#if enableDebug && debugRPM
#define DEBUG_RPM(x, ...)  Serial.printf("[RPM] " x "\n", ##__VA_ARGS__)
#define DEBUG_RPM_(x, ...) Serial.printf("[RPM] " x, ##__VA_ARGS__)
#else
#define DEBUG_RPM(x, ...)
#define DEBUG_RPM_(x, ...)
#endif
#if enableDebug && debugDSG
#define DEBUG_DSG(x, ...)  Serial.printf("[DSG] " x "\n", ##__VA_ARGS__)
#define DEBUG_DSG_(x, ...) Serial.printf("[DSG] " x, ##__VA_ARGS__)
#else
#define DEBUG_DSG(x, ...)
#define DEBUG_DSG_(x, ...)
#endif
#if enableDebug && debugUDS
#define DEBUG_UDS(x, ...)  Serial.printf("[UDS] " x "\n", ##__VA_ARGS__)
#define DEBUG_UDS_(x, ...) Serial.printf("[UDS] " x, ##__VA_ARGS__)
#else
#define DEBUG_UDS(x, ...)
#define DEBUG_UDS_(x, ...)
#endif
#if enableDebug && debugSavvy
#define DEBUG_SAVVY(x, ...)  Serial.printf("[SAVVY] " x "\n", ##__VA_ARGS__)
#define DEBUG_SAVVY_(x, ...) Serial.printf("[SAVVY] " x, ##__VA_ARGS__)
#else
#define DEBUG_SAVVY(x, ...)
#define DEBUG_SAVVY_(x, ...)
#endif
#if enableDebug && debugCtrl
#define DEBUG_CTRL(x, ...)  Serial.printf("[CTRL] " x "\n", ##__VA_ARGS__)
#define DEBUG_CTRL_(x, ...) Serial.printf("[CTRL] " x, ##__VA_ARGS__)
#else
#define DEBUG_CTRL(x, ...)
#define DEBUG_CTRL_(x, ...)
#endif
#if enableDebug && debugFB
#define DEBUG_FB(x, ...)  Serial.printf("[FB] " x "\n", ##__VA_ARGS__)
#define DEBUG_FB_(x, ...) Serial.printf("[FB] " x, ##__VA_ARGS__)
#else
#define DEBUG_FB(x, ...)
#define DEBUG_FB_(x, ...)
#endif
#if enableDebug && debugSys
#define DEBUG_PRINT(x)    Serial.print(x)
#define DEBUG_PRINTLN(x)  Serial.println(x)
#define DEBUG_PRINTF(...) Serial.printf(__VA_ARGS__)
#else
#define DEBUG_PRINT(x)
#define DEBUG_PRINTLN(x)
#define DEBUG_PRINTF(...)
#endif
#include "SpeedPulserPro_globals.h"
