adamforbes92/speedPulserPro/PlatformIO/src/SpeedPulserPro_motorCal.cpp

#include "SpeedPulserPro_motorCal.h"
#include "SpeedPulserPro_calBuilder.h"

// ============================================================================
// Motor Performance Calibration Arrays (10-bit resolution)
// ============================================================================

// VW MK1/MK2 - 120mph cluster; by Martin Springell
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

struct CalibrationProfile
{
    const char *name;
    const uint16_t *dutyCycles;
};

// hi

// Add new calibrations in this table only.
// ID exposed to API/UI is 1-based table index.
static const CalibrationProfile calibrationProfiles[] = {
    {"VW - 120mph; Martin Springell", motorPerformance1},
    {"VW - 120mph; Forbes-Automotive", motorPerformance2},
    {"VW - 140mph; Forbes-Automotive", motorPerformance3},
    {"VW - 160mph; Forbes-Automotive", motorPerformance4},
    {"VW - 300kph; Forbes-Automotive", motorPerformance5},
    {"Ford - 120mph_1; Forbes-Automotive", motorPerformance6},
    {"Ford - 120mph_2; Forbes-Automotive", motorPerformance7},
    {"FIAT - 40-160mph; Forbes-Automotive", motorPerformance8},
    {"FIAT - 20-110mph; Forbes-Automotive", motorPerformance9},
    {"Merc - 120mph; Forbes-Automotive", motorPerformance10},
    {"Smiths - 70mph; Forbes-Automotive", motorPerformance11},
    {"Smiths - 90mph; Forbes-Automotive", motorPerformance12},
    {"VW Bay VDO - 90mph", motorPerformance13},
    {"Smiths - 150mph; Forbes-Automotive", motorPerformance14},
    {"Opel Manta A-72; Forbes-Automotive", motorPerformance15},
    {"VW - 120mph; Tara", motorPerformance16},
    {"BMW - 140mph VDO; Forbes Automotive", motorPerformance17},
    {"Smiths Jaguar 260kmh; Forbes Automotive", motorPerformance18}};

static constexpr uint8_t calibrationProfileCount = sizeof(calibrationProfiles) / sizeof(calibrationProfiles[0]);

const char *getCalibrationText(uint8_t calibrationVal)
{
    if (calibrationVal == CUSTOM_CAL_ID)
    {
        return customCalName;
    }
    if (calibrationVal == 0 || calibrationVal > calibrationProfileCount)
    {
        return calibrationProfiles[0].name;
    }
    return calibrationProfiles[calibrationVal - 1].name;
}

uint8_t getCalibrationCount()
{
    return calibrationProfileCount;
}

void updateMotorArray()
{
    // Custom (SpeedPulser) calibration: build the table from user anchors
    // instead of copying a stored PROGMEM preset.
    if (motorPerformanceVal == CUSTOM_CAL_ID)
    {
        buildCustomCalTable();
        // A custom cal captured in MPH means the cluster reads MPH, so mirror
        // that into the runtime conversion (covers boot and dropdown selection).
        if (customCalValid && customCalUnitMph) convertToMPH = true;
        updateMotorPerformance = false;
        return;
    }

    if (motorPerformanceVal == 0 || motorPerformanceVal > calibrationProfileCount)
    {
        motorPerformanceVal = 1;
    }

    memcpy_P(&motorPerformance, calibrationProfiles[motorPerformanceVal - 1].dutyCycles, sizeof(motorPerformance));
    updateMotorPerformance = false;
}
