adamforbes92/speedPulserPro/PlatformIO/src/SpeedPulserPro_eep.cpp

#include "SpeedPulserPro_eep.h"
#include "SpeedPulserPro_control.h"
#include "SpeedPulserPro_voltage.h"
#include "SpeedPulserPro_driveCal.h"
#include "SpeedPulserPro_gps.h"
#include "freertos/FreeRTOS.h"
#include "freertos/semphr.h"

static SemaphoreHandle_t eepWriteMutex = nullptr;

static SemaphoreHandle_t getEEPWriteMutex()
{
  if (eepWriteMutex == nullptr)
  {
    eepWriteMutex = xSemaphoreCreateMutex();
  }

  return eepWriteMutex;
}

void readEEP()
{
  // Read GPS update rate (Hz), default 1
#if serialDebugEEP
  Serial.println("[EEP] EEPROM initialising!");
#endif

  pref.begin("useHall", false);
  pref.begin("useDSG", false);
  pref.begin("useGPS", false);
  pref.begin("useABS", false);
  pref.begin("useECU", false);
  pref.begin("useUDS", false);
  pref.begin("useTP20", false);
  pref.begin("useRPMHall", false);
  pref.begin("useRPMCAN", false);
  pref.begin("brdSpeedEn", false);
  pref.begin("brdSpeedID", false);
  pref.begin("brdSpeedDLC", false);
  pref.begin("brdSpeedLoByte", false);
  pref.begin("brdSpeedHiByte", false);
  pref.begin("brdSpeedLE", false);
  pref.begin("brdSpeedScale", false);
  pref.begin("brdSpeedOffset", false);
  pref.begin("brdSD0", false);
  pref.begin("brdSD1", false);
  pref.begin("brdSD2", false);
  pref.begin("brdSD3", false);
  pref.begin("brdSD4", false);
  pref.begin("brdSD5", false);
  pref.begin("brdSD6", false);
  pref.begin("brdSD7", false);
  pref.begin("coilType", false);
  pref.begin("convertToMPH", false);

  pref.begin("hasNeedleSweep", false);
  pref.begin("linSpeedSweep", false);
  pref.begin("sweepSpeed", false);

  pref.begin("maxFreqHall", false);
  pref.begin("maxFreqCAN", false);
  pref.begin("maxSpeed", false);
  pref.begin("maxRPM", false);
  pref.begin("clusterRPMLimit", false);

  pref.begin("speedOffset", false);
  pref.begin("spdOffsetPos", false);
  pref.begin("useGlobalOffset", false);
  pref.begin("useCurve", false);
  pref.begin("curveO0", false);
  pref.begin("curveO1", false);
  pref.begin("curveO2", false);
  pref.begin("curveO3", false);
  pref.begin("curveO4", false);
  pref.begin("motorPerfVal", false);

  pref.begin("stepRPM", false);
  pref.begin("stepSpeed", false);
  pref.begin("averageFilter", false);
  pref.begin("avgFilterHall", false);
  pref.begin("avgFilterRPM", false);

  pref.begin("gpsUpdateRateHz", false);
  pref.begin("useAftermarket", false);
  pref.begin("amSpeedID", false);
  pref.begin("amSpeedLow", false);
  pref.begin("amSpeedHigh", false);
  pref.begin("amSpeedLE", false);
  pref.begin("amSpeedScale", false);
  pref.begin("amSpeedOffset", false);

  pref.begin("fbEnable", false);
  pref.begin("pidKp", false);
  pref.begin("pidKi", false);
  pref.begin("pidKd", false);
  pref.begin("fbDeadband", false);
  pref.begin("fbMinSpd", false);
  pref.begin("fbMaxFreq", false);
  pref.begin("revDir", false);

  if (pref.getUChar("motorPerfVal", 255) == 255)
  {
#if serialDebugEEP
    Serial.println("[EEP] First run, set Bluetooth module, write Software Version etc");
    Serial.print("[EEP] motorPerfVal: ");
    Serial.println(pref.getUChar("motorPerfVal", 255));
#endif
    pref.putBool("useHall", useHall);
    pref.putBool("useDSG", useDSG);
    pref.putBool("useGPS", useGPS);
    pref.putBool("useABS", useABS);
    pref.putBool("useECU", useECU);
    pref.putBool("useUDS", useUDS);
    pref.putBool("useTP20", useTP20);
    pref.putBool("useRPMHall", useRPMHall);
    pref.putBool("useRPMCAN", useRPMCAN);
    pref.putBool("brdSpeedEn", broadcastSpeedEnabled);
    pref.putUInt("brdSpeedID", broadcastSpeedID);
    pref.putUChar("brdSpeedDLC", broadcastSpeedDLC);
    pref.putUChar("brdSpeedLoByte", broadcastSpeedLowByte);
    pref.putUChar("brdSpeedHiByte", broadcastSpeedHighByte);
    pref.putBool("brdSpeedLE", broadcastSpeedLittleEndian);
    pref.putFloat("brdSpeedScale", broadcastSpeedScale);
    pref.putShort("brdSpeedOffset", broadcastSpeedOffset);
    for (uint8_t i = 0; i < 8; i++)
    {
      String dk = "brdSD" + String(i);
      pref.putUChar(dk.c_str(), broadcastSpeedData[i]);
    }
    pref.putBool("coilType", coilType);
    pref.putBool("convertToMPH", convertToMPH);

    pref.putBool("hasNeedleSweep", hasNeedleSweep);
    pref.putBool("linSpeedSweep", linearSpeedSweep);
    pref.putUChar("sweepSpeed", sweepSpeed);

    pref.putUShort("maxFreqHall", maxFreqHall);
    pref.putUShort("maxFreqCAN", maxFreqCAN);
    pref.putUShort("maxSpeed", maxSpeed);
    pref.putUShort("maxRPM", maxRPM);
    pref.putUShort("clusterRPMLimit", clusterRPMLimit);

    pref.putUChar("speedOffset", speedOffset);
    pref.putBool("spdOffsetPos", speedOffsetPositive);
    pref.putBool("useGlobalOffset", useGlobalSpeedOffset);
    pref.putBool("useCurve", useSpeedOffsetCurve);
    pref.putShort("curveO0", speedOffsetCurveOffsets[0]);
    pref.putShort("curveO1", speedOffsetCurveOffsets[1]);
    pref.putShort("curveO2", speedOffsetCurveOffsets[2]);
    pref.putShort("curveO3", speedOffsetCurveOffsets[3]);
    pref.putShort("curveO4", speedOffsetCurveOffsets[4]);
    pref.putUChar("motorPerfVal", motorPerformanceVal);

    pref.putUShort("stepRPM", stepRPM);
    pref.putUShort("stepSpeed", stepSpeed);
    pref.putUChar("averageFilter", averageFilterHall);
    pref.putUChar("avgFilterHall", averageFilterHall);
    pref.putUChar("avgFilterRPM", averageFilterRPM);
    pref.putUChar("gpsUpdateRateHz", gpsUpdateRateHz);
    pref.putBool("useAftermarket", useAftermarket);
    pref.putUInt("amSpeedID", aftermarketSpeedID);
    pref.putUChar("amSpeedLow", aftermarketSpeedLowByte);
    pref.putUChar("amSpeedHigh", aftermarketSpeedHighByte);
    pref.putBool("amSpeedLE", aftermarketSpeedLittleEndian);
    pref.putFloat("amSpeedScale", aftermarketSpeedScale);
    pref.putShort("amSpeedOffset", aftermarketSpeedOffset);

    for (uint8_t i = 1; i <= 6; i++)
    {
      String rk = "dsgRatio" + String(i);
      pref.putFloat(rk.c_str(), dsgGearRatio[i]);
    }
    pref.putFloat("dsgFinal14", dsgFinalDrive14);
    pref.putFloat("dsgFinal56", dsgFinalDrive56);
    pref.putFloat("dsgTireCirc", dsgTireCirc);

    pref.putBool("revDir", reverseDirection);

    pref.putBool("fbEnable", feedbackEnable);
    pref.putFloat("pidKp", pidKp);
    pref.putFloat("pidKi", pidKi);
    pref.putFloat("pidKd", pidKd);
    pref.putFloat("fbDeadband", feedbackDeadband);
    pref.putUShort("fbMinSpd", feedbackMinSpeed);
    pref.putUShort("fbMaxFreq", feedbackMaxFreq);

#if SPP_HAS_VOLTAGE_CTRL
    // Buck voltage control (S3 board)
    pref.putBool("vcEnable", voltageControlEnable);
    pref.putFloat("vcPwmNom", vcPwmNominal);
#endif

#if SPP_HAS_VR
    // VR (variable-reluctance) speed input
    pref.putBool("useVR", useVR);
    pref.putUShort("maxFreqVR", maxFreqVR);
    pref.putUChar("avgFilterVR", averageFilterVR);
#endif
#if SPP_HAS_SPEED_BIAS
    pref.putUChar("spdBias", speedInputBias);
#endif
  }
  else
  {
    useHall = pref.getBool("useHall", true);
    useDSG = pref.getBool("useDSG", false);
    useGPS = pref.getBool("useGPS", false);
    useABS = pref.getBool("useABS", false);
    useECU = pref.getBool("useECU", false);
    useUDS = pref.getBool("useUDS", false);
    useTP20 = pref.getBool("useTP20", false);
    useRPMHall = pref.getBool("useRPMHall", true);
    useRPMCAN = pref.getBool("useRPMCAN", false);
    broadcastSpeedEnabled = pref.getBool("brdSpeedEn", false);
    broadcastSpeedID = pref.getUInt("brdSpeedID", HALDEX_ID) & 0x7FF;
    broadcastSpeedDLC = pref.getUChar("brdSpeedDLC", 8);
    broadcastSpeedLowByte = pref.getUChar("brdSpeedLoByte", 2);
    broadcastSpeedHighByte = pref.getUChar("brdSpeedHiByte", 3);
    broadcastSpeedLittleEndian = pref.getBool("brdSpeedLE", true);
    broadcastSpeedScale = pref.getFloat("brdSpeedScale", 0.781f);
    broadcastSpeedOffset = pref.getShort("brdSpeedOffset", 0);
    for (uint8_t i = 0; i < 8; i++)
    {
      String dk = "brdSD" + String(i);
      broadcastSpeedData[i] = pref.getUChar(dk.c_str(), 0);
    }
    coilType = pref.getBool("coilType", true);
    convertToMPH = pref.getBool("convertToMPH", false);

    hasNeedleSweep = pref.getBool("hasNeedleSweep", false);
    linearSpeedSweep = pref.getBool("linSpeedSweep", true);
    sweepSpeed = pref.getUChar("sweepSpeed", 18);

    maxFreqHall = pref.getUShort("maxFreqHall", 200);
    maxFreqCAN = pref.getUShort("maxFreqCAN", 200);
    maxSpeed = pref.getUShort("maxSpeed", 200);
    maxRPM = pref.getUShort("maxRPM", 230);
    clusterRPMLimit = pref.getUShort("clusterRPMLimit", 7000);

    speedOffset = pref.getUChar("speedOffset", 0);
    // Saved as "spdOffsetPos" since after V5.02: the old name "speedOffsetPositive" was 19 letters,
    // over the ESP32's 15-letter limit, so it never saved and a + offset came back as - after a restart
    speedOffsetPositive = pref.getBool("spdOffsetPos", 0);
    useGlobalSpeedOffset = pref.getBool("useGlobalOffset", true);
    useSpeedOffsetCurve = pref.getBool("useCurve", false);
    speedOffsetCurveOffsets[0] = pref.getShort("curveO0", 0);
    speedOffsetCurveOffsets[1] = pref.getShort("curveO1", 0);
    speedOffsetCurveOffsets[2] = pref.getShort("curveO2", 0);
    speedOffsetCurveOffsets[3] = pref.getShort("curveO3", 0);
    speedOffsetCurveOffsets[4] = pref.getShort("curveO4", 0);
    motorPerformanceVal = pref.getUChar("motorPerfVal", 0);

    stepRPM = pref.getUShort("stepRPM", 14);
    stepSpeed = pref.getUShort("stepSpeed", 17);

    uint8_t legacyAverage = pref.getUChar("averageFilter", 6);
    averageFilterHall = pref.getUChar("avgFilterHall", legacyAverage);
    averageFilterRPM = pref.getUChar("avgFilterRPM", legacyAverage);
    gpsUpdateRateHz = pref.getUChar("gpsUpdateRateHz", 1);
    useAftermarket = pref.getBool("useAftermarket", false);
    aftermarketSpeedID = pref.getUInt("amSpeedID", 0x200) & 0x7FF;
    aftermarketSpeedLowByte = pref.getUChar("amSpeedLow", 0);
    aftermarketSpeedHighByte = pref.getUChar("amSpeedHigh", 1);
    aftermarketSpeedLittleEndian = pref.getBool("amSpeedLE", true);
    aftermarketSpeedScale = pref.getFloat("amSpeedScale", 1.0f);
    aftermarketSpeedOffset = pref.getShort("amSpeedOffset", 0);

    for (uint8_t i = 1; i <= 6; i++)
    {
      String rk = "dsgRatio" + String(i);
      float loaded = pref.getFloat(rk.c_str(), dsgGearRatio[i]);
      if (loaded > 0.0f) dsgGearRatio[i] = loaded;
    }
    dsgFinalDrive14 = pref.getFloat("dsgFinal14", dsgFinalDrive14);
    dsgFinalDrive56 = pref.getFloat("dsgFinal56", dsgFinalDrive56);
    dsgTireCirc = pref.getFloat("dsgTireCirc", dsgTireCirc);

    reverseDirection = pref.getBool("revDir", false);

    feedbackEnable = pref.getBool("fbEnable", false);
    pidKp = pref.getFloat("pidKp", 0.15f);
    pidKi = pref.getFloat("pidKi", 1.3f);
    pidKd = pref.getFloat("pidKd", 0.0f);
    feedbackDeadband = pref.getFloat("fbDeadband", 1.5f);
    feedbackMinSpeed = pref.getUShort("fbMinSpd", 40);
    feedbackMaxFreq = pref.getUShort("fbMaxFreq", 254);

#if SPP_HAS_VOLTAGE_CTRL
    // Buck voltage control (S3 board)
    voltageControlEnable = pref.getBool("vcEnable", true);
    vcPwmNominal = pref.getFloat("vcPwmNom", 0.80f);
#endif

#if SPP_HAS_VR
    // VR (variable-reluctance) speed input
    useVR = pref.getBool("useVR", false);
    maxFreqVR = pref.getUShort("maxFreqVR", 200);
    averageFilterVR = pref.getUChar("avgFilterVR", legacyAverage);
#else
    // A settings image carried over from a VR-capable build may have "VR" as the
    // active source; with no VR input on this board make sure hall takes over.
    if (pref.getBool("useVR", false) && !useDSG && !useGPS && !useABS && !useECU && !useUDS && !useTP20 && !useAftermarket)
      useHall = true;
#endif
#if SPP_HAS_SPEED_BIAS
    speedInputBias = pref.getUChar("spdBias", SPEED_BIAS_NONE);
#endif
  }

#if SPP_HAS_VOLTAGE_CTRL
  // Test Board result and V5.01 drive settings + calibration marks. Read outside
  // the first-run branch: units updated from older firmware have none of these
  // keys yet, so they come up with the defaults / "not calibrated".
  vcRailMaxV = pref.getFloat("vcRailMax", vcRailMaxV);
  vcTrimGain = pref.getFloat("vcTrimG", vcTrimGain);
  vcTrimLimit = pref.getFloat("vcTrimL", vcTrimLimit);
  driveCalCount = 0;
  const uint8_t dcN = pref.getUChar("dcN", 0);
  if (dcN > 0 && dcN <= DRIVE_CAL_MAX &&
      pref.getBytesLength("dcPts") == sizeof(DriveCalPoint) * dcN)
  {
    pref.getBytes("dcPts", driveCal, sizeof(DriveCalPoint) * dcN);
    driveCalCount = dcN;
  }
  else if (!pref.isKey("dcN"))
  {
    // V5.00 stored one top-speed point; carry it over as the first mark.
    const uint16_t topSpd = pref.getUShort("calTopSpd", 0);
    const float topHz = pref.getFloat("calTopHz", 0.0f);
    const float topV = pref.getFloat("calTopV", 0.0f);
    const float topPwm = pref.getFloat("calTopPwm", 0.0f);
    if (topSpd > 0 && topV > 0.0f && topPwm > 0.0f)
    {
      driveCal[0] = {topSpd, topHz, topV * topPwm, topV, topPwm};
      driveCalCount = 1;
      DEBUG_EEP("migrated V5.00 top point %u = %.1f Hz @ %.2f V x %.0f%%", topSpd, topHz, topV, topPwm * 100.0f);
    }
  }
  boardTestCode = pref.getUChar("btCode", BT_NOT_RUN);
  for (uint8_t i = 0; i < BOARD_TEST_POINTS; i++)
  {
    char key[8];
    snprintf(key, sizeof key, "btV%u", (unsigned)i);
    boardTestMeasV[i] = pref.getFloat(key, 0.0f);
  }
  railFitV0 = pref.getFloat("btFitV0", RAIL_MODEL_V0);
  railFitSlope = pref.getFloat("btFitK", RAIL_MODEL_SLOPE);
  railFitValid = (boardTestCode == BT_PASS && railFitSlope < -6.0f && railFitSlope > -16.0f);
  if (!railFitValid)
  {
    railFitV0 = RAIL_MODEL_V0;
    railFitSlope = RAIL_MODEL_SLOPE;
  }
  syncFeedbackMaxFreq(); // Hz-at-maxSpeed follows the captured marks
#endif

  averageFilterHall = constrain(averageFilterHall, 1, 10);
  averageFilterRPM = constrain(averageFilterRPM, 1, 10);
#if SPP_HAS_VR
  averageFilterVR = constrain(averageFilterVR, 1, 10);
#endif
#if SPP_HAS_SPEED_BIAS
  if (speedInputBias > SPEED_BIAS_PULL_DOWN) speedInputBias = SPEED_BIAS_NONE;
#endif
  broadcastSpeedLowByte = constrain(broadcastSpeedLowByte, 0, 7);
  broadcastSpeedHighByte = constrain(broadcastSpeedHighByte, 0, 7);
  broadcastSpeedDLC = constrain(broadcastSpeedDLC, 0, 8);
  normaliseSpeedOffsetCurve();
#if serialDebugEEP
  Serial.println("[EEP] EEPROM initialised with...");
  Serial.print("[EEP] testSpeedo: ");
  Serial.println(testSpeedo);
  Serial.print("[EEP] tempSpeed: ");
  Serial.println(tempSpeed);
  Serial.print("[EEP] hasNeedleSweep: ");
  Serial.println(hasNeedleSweep);
  Serial.print("[EEP] sweepSpeed: ");
  Serial.println(sweepSpeed);
  Serial.print("[EEP] maxFreqHall: ");
  Serial.println(maxFreqHall);
  Serial.print("[EEP] maxFreqCAN: ");
  Serial.println(maxFreqCAN);
  Serial.print("[EEP] maxSpeed: ");
  Serial.println(maxSpeed);
  Serial.print("[EEP] speedOffset: ");
  Serial.println(speedOffset);
  Serial.print("[EEP] speedOffsetPositive: ");
  Serial.println(speedOffsetPositive);
  Serial.print("[EEP] motorPerformanceVal: ");
  Serial.println(motorPerformanceVal);
#endif
}

void writeEEP()
{
  SemaphoreHandle_t writeMutex = getEEPWriteMutex();
  if ((writeMutex == nullptr) || (xSemaphoreTake(writeMutex, pdMS_TO_TICKS(1000)) != pdTRUE))
  {
    return;
  }

  // Write GPS update rate
  pref.putUChar("gpsUpdateRateHz", gpsUpdateRateHz);
#if serialDebugEEP
  Serial.println("[EEP] Writing EEPROM...");
#endif

  pref.putBool("useHall", useHall);
  pref.putBool("useDSG", useDSG);
  pref.putBool("useGPS", useGPS);
  pref.putBool("useABS", useABS);
  pref.putBool("useECU", useECU);
  pref.putBool("useUDS", useUDS);
  pref.putBool("useTP20", useTP20);
  pref.putBool("useRPMHall", useRPMHall);
  pref.putBool("useRPMCAN", useRPMCAN);
  pref.putBool("brdSpeedEn", broadcastSpeedEnabled);
  pref.putUInt("brdSpeedID", broadcastSpeedID);
  pref.putUChar("brdSpeedDLC", broadcastSpeedDLC);
  pref.putUChar("brdSpeedLoByte", broadcastSpeedLowByte);
  pref.putUChar("brdSpeedHiByte", broadcastSpeedHighByte);
  pref.putBool("brdSpeedLE", broadcastSpeedLittleEndian);
  pref.putFloat("brdSpeedScale", broadcastSpeedScale);
  pref.putShort("brdSpeedOffset", broadcastSpeedOffset);
  for (uint8_t i = 0; i < 8; i++)
  {
    String dk = "brdSD" + String(i);
    pref.putUChar(dk.c_str(), broadcastSpeedData[i]);
  }
  pref.putBool("coilType", coilType);
  pref.putBool("convertToMPH", convertToMPH);

  pref.putBool("hasNeedleSweep", hasNeedleSweep);
  pref.putBool("linSpeedSweep", linearSpeedSweep);
  pref.putUChar("sweepSpeed", sweepSpeed);

  pref.putUShort("maxFreqHall", maxFreqHall);
  pref.putUShort("maxFreqCAN", maxFreqCAN);
  pref.putUShort("maxSpeed", maxSpeed);
  pref.putUShort("maxRPM", maxRPM);
  pref.putUShort("clusterRPMLimit", clusterRPMLimit);

  pref.putUChar("speedOffset", speedOffset);
  pref.putBool("spdOffsetPos", speedOffsetPositive);
  pref.putBool("useGlobalOffset", useGlobalSpeedOffset);
  pref.putBool("useCurve", useSpeedOffsetCurve);
  pref.putShort("curveO0", speedOffsetCurveOffsets[0]);
  pref.putShort("curveO1", speedOffsetCurveOffsets[1]);
  pref.putShort("curveO2", speedOffsetCurveOffsets[2]);
  pref.putShort("curveO3", speedOffsetCurveOffsets[3]);
  pref.putShort("curveO4", speedOffsetCurveOffsets[4]);
  pref.putUChar("motorPerfVal", motorPerformanceVal);

  pref.putUShort("stepRPM", stepRPM);
  pref.putUShort("stepSpeed", stepSpeed);
  pref.putUChar("averageFilter", averageFilterHall);
  pref.putUChar("avgFilterHall", averageFilterHall);
  pref.putUChar("avgFilterRPM", averageFilterRPM);

  pref.putUChar("gpsUpdateRateHz", gpsUpdateRateHz);
  pref.putBool("useAftermarket", useAftermarket);
  pref.putUInt("amSpeedID", aftermarketSpeedID);
  pref.putUChar("amSpeedLow", aftermarketSpeedLowByte);
  pref.putUChar("amSpeedHigh", aftermarketSpeedHighByte);
  pref.putBool("amSpeedLE", aftermarketSpeedLittleEndian);
  pref.putFloat("amSpeedScale", aftermarketSpeedScale);
  pref.putShort("amSpeedOffset", aftermarketSpeedOffset);

  for (uint8_t i = 1; i <= 6; i++)
  {
    String rk = "dsgRatio" + String(i);
    pref.putFloat(rk.c_str(), dsgGearRatio[i]);
  }
  pref.putFloat("dsgFinal14", dsgFinalDrive14);
  pref.putFloat("dsgFinal56", dsgFinalDrive56);
  pref.putFloat("dsgTireCirc", dsgTireCirc);

  pref.putBool("revDir", reverseDirection);

  pref.putBool("fbEnable", feedbackEnable);
  pref.putFloat("pidKp", pidKp);
  pref.putFloat("pidKi", pidKi);
  pref.putFloat("pidKd", pidKd);
  pref.putFloat("fbDeadband", feedbackDeadband);
  pref.putUShort("fbMinSpd", feedbackMinSpeed);
  pref.putUShort("fbMaxFreq", feedbackMaxFreq);

#if SPP_HAS_VOLTAGE_CTRL
  // Buck voltage control (S3 board)
  pref.putBool("vcEnable", voltageControlEnable);
  pref.putFloat("vcPwmNom", vcPwmNominal);
  pref.putFloat("vcRailMax", vcRailMaxV);
  pref.putFloat("vcTrimG", vcTrimGain);
  pref.putFloat("vcTrimL", vcTrimLimit);
  pref.putUChar("dcN", driveCalCount);
  if (driveCalCount > 0)
  {
    pref.putBytes("dcPts", driveCal, sizeof(DriveCalPoint) * driveCalCount);
  }
  if (!boardTestActive) // don't save a half-finished test
  {
    pref.putUChar("btCode", boardTestCode);
    for (uint8_t i = 0; i < BOARD_TEST_POINTS; i++)
    {
      char key[8];
      snprintf(key, sizeof key, "btV%u", (unsigned)i);
      pref.putFloat(key, boardTestMeasV[i]);
    }
    pref.putFloat("btFitV0", railFitV0);
    pref.putFloat("btFitK", railFitSlope);
  }
#endif

#if SPP_HAS_VR
  // VR (variable-reluctance) speed input
  pref.putBool("useVR", useVR);
  pref.putUShort("maxFreqVR", maxFreqVR);
  pref.putUChar("avgFilterVR", averageFilterVR);
#endif
#if SPP_HAS_SPEED_BIAS
  pref.putUChar("spdBias", speedInputBias);
#endif

#if serialDebugEEP
  Serial.println("[EEP] Written EEPROM with data:...");
  Serial.print("[EEP] testSpeedo: ");
  Serial.println(testSpeedo);
  Serial.print("[EEP] tempSpeed: ");
  Serial.println(tempSpeed);
  Serial.print("[EEP] hasNeedleSweep: ");
  Serial.println(hasNeedleSweep);
  Serial.print("[EEP] sweepSpeed: ");
  Serial.println(sweepSpeed);
  Serial.print("[EEP] maxFreqHall: ");
  Serial.println(maxFreqHall);
  Serial.print("[EEP] maxFreqCAN: ");
  Serial.println(maxFreqCAN);
  Serial.print("[EEP] maxSpeed: ");
  Serial.println(maxSpeed);
  Serial.print("[EEP] speedOffset: ");
  Serial.println(speedOffset);
  Serial.print("[EEP] speedOffsetPositive: ");
  Serial.println(speedOffsetPositive);
  Serial.print("[EEP] motorPerformanceVal: ");
  Serial.println(motorPerformanceVal);
#endif

  xSemaphoreGive(writeMutex);
}
