adamforbes92/speedPulserPro/PlatformIO/src/SpeedPulserPro_voltage.cpp

#include "SpeedPulserPro_config.h"
#include "SpeedPulserPro_control.h"
#include "SpeedPulserPro_io.h"
#include "SpeedPulserPro_voltage.h"

#if SPP_HAS_VOLTAGE_CTRL
// ---------------------------------------------------------------------------
// SpeedPulserPro — buck voltage-control hardware layer (S3 board only).
// See SpeedPulserPro_voltage.h for the design overview. This file owns the
// V_ADJ PWM "DAC", the buck-enable pin, the drive -> rail + PWM split, the
// motor-rail read-back and the Test Board routine. The speed -> drive
// calibration lives in SpeedPulserPro_driveCal.cpp and the control law in
// SpeedPulserPro_control.cpp. Mirrors SpeedPulser V5.01 (same injection /
// sense network on both PCBs).
// ---------------------------------------------------------------------------

// ===== Board identity + live state =====
bool  boardHasVoltageControl = true; // the S3 PCB always has the buck — set by the build, not a strap
bool  boardIdStrapOk = false;
bool  buckEnabled = false;
float lastVoltageCmd = 0.0f;
float lastRailCmdV = 0.0f;
float lastPwmFrac = 0.0f;
float lastDriveV = 0.0f;
float motorRailV = 0.0f;

// ===== User configuration (defaults; overwritten from EEP) =====
bool  voltageControlEnable = true;
float vcPwmNominal = 0.80f; // PWM held while the rail does the work
float vcRailMaxV   = RAIL_V_CEIL;
float vcTrimGain   = 0.50f; // gentle: a 10 % speed error moves the drive 5 %/s
float vcTrimLimit  = 0.20f; // feedback may move the calibrated drive by at most ±20 %

// ===== Calibration =====
float tempDriveV = 0.0f;

// ===== Board test =====
volatile bool boardTestActive = false;
uint8_t boardTestCode = BT_NOT_RUN;
float   boardTestTargetV[BOARD_TEST_POINTS] = {5.0f, 7.5f, 10.0f}; // ascending: the buck can only
                                                                   // pull the rail UP quickly
float   boardTestMeasV[BOARD_TEST_POINTS] = {0.0f, 0.0f, 0.0f};
bool    railFitValid = false;
float   railFitV0 = RAIL_MODEL_V0;
float   railFitSlope = RAIL_MODEL_SLOPE;

// Read the BOARD_ID strap (IO7, R12 1k to GND) once at boot. The S3 build already
// knows the buck is fitted; this only flags a mismatch (e.g. an S3 image on some
// other S3 hardware) in the log and the UI. Passive and instant.
void detectBoardVersion()
{
    pinMode(pinBoardVersion, INPUT_PULLUP);
    delayMicroseconds(50); // let the node settle through the internal pull-up
    boardIdStrapOk = (digitalRead(pinBoardVersion) == LOW);
    DEBUG_IO("board ID strap: IO%d=%s%s", pinBoardVersion, boardIdStrapOk ? "LOW" : "HIGH",
             boardIdStrapOk ? "" : " (expected LOW on the S3 board - check R12)");
}

// ===== Rail volts -> V_ADJ duty =====
// Through this board's measured line when the Test Board has passed, otherwise
// the design-nominal model. INVERSE: more duty = lower rail.
static float vadjDutyForVolts(float volts, bool useFit)
{
    const float v0 = useFit ? railFitV0 : RAIL_MODEL_V0;
    const float k = useFit ? railFitSlope : RAIL_MODEL_SLOPE;
    float d = (k < -0.1f) ? (volts - v0) / k : 1.0f; // guard a nonsense slope -> lowest rail
    if (d < 0.0f) d = 0.0f;
    if (d > 1.0f) d = 1.0f;
    return d;
}

static void writeVadjDuty(float d01)
{
    ledc_set_duty(LEDC_MODE, LEDC_CHANNEL_VADJ, (uint32_t)(d01 * (float)VADJ_DUTY_MAX + 0.5f));
    ledc_update_duty(LEDC_MODE, LEDC_CHANNEL_VADJ);
}

void setMotorRailVolts(float volts)
{
    if (volts < RAIL_V_FLOOR) volts = RAIL_V_FLOOR;
    if (volts > RAIL_V_CEIL) volts = RAIL_V_CEIL;
    lastRailCmdV = volts;
    lastVoltageCmd = (volts - RAIL_V_FLOOR) / (RAIL_V_CEIL - RAIL_V_FLOOR);
    writeVadjDuty(vadjDutyForVolts(volts, railFitValid));
}

// ===== Drive -> rail + PWM =====
// Minimum Rail is always the hardware floor: a higher one only gives away the
// smooth rail-only range at the bottom. Maximum Rail is the user's, kept inside
// what the hardware can make.
static float railLoV() { return RAIL_V_FLOOR; }
static float railHiV() { return constrain(vcRailMaxV, railLoV(), RAIL_V_CEIL); }

float driveMaxV()
{
    return railHiV(); // Maximum Rail x 100 % PWM
}

// One drive number (V = rail x PWM) -> the rail and PWM that make it. Between
// Min x Nominal and Max x Nominal the PWM stays at Nominal and only the rail
// moves; below, the rail stays at Minimum and the PWM falls to zero; above, the
// rail stays at Maximum and the PWM rises to 100 %. Continuous and monotonic, so
// calibration can interpolate it.
uint16_t applyMotorDrive(float driveV)
{
    const float lo = railLoV();
    const float hi = railHiV();
    const float pn = (vcPwmNominal > 0.05f) ? vcPwmNominal : 0.05f;
    if (driveV < 0.0f) driveV = 0.0f;
    if (driveV > hi) driveV = hi;

    float rail = driveV / pn;
    float pwm = pn;
    if (rail < lo)
    {
        rail = lo;
        pwm = driveV / lo;
    }
    else if (rail > hi)
    {
        rail = hi;
        pwm = driveV / hi;
    }
    if (pwm > 1.0f) pwm = 1.0f;

    lastDriveV = driveV;
    lastPwmFrac = pwm;
    setMotorRailVolts(rail);
    uint32_t duty = (uint32_t)(pwm * (float)PWM_DUTY_MAX + 0.5f);
    if (duty > PWM_DUTY_MAX) duty = PWM_DUTY_MAX;
    setMotorDutyRaw(duty);
    return (uint16_t)duty;
}

void initVoltageControl()
{
    DEBUG_IO("setting up buck voltage control...");

    // Buck enable pin: default OFF (LOW) until a safe voltage is set and we enable it.
    pinMode(pinBuckEnable, OUTPUT);
    digitalWrite(pinBuckEnable, LOW);
    buckEnabled = false;

    // V_ADJ PWM "DAC" on its own LEDC timer/channel (CH2/TIMER2).
    ledc_timer_config_t vadj_timer = {
        .speed_mode = LEDC_MODE,
        .duty_resolution = (ledc_timer_bit_t)VADJ_RESOLUTION,
        .timer_num = LEDC_TIMER_VADJ,
        .freq_hz = VADJ_PWM_FREQUENCY,
        .clk_cfg = LEDC_AUTO_CLK};
    ledc_timer_config(&vadj_timer);

    ledc_channel_config_t vadj_channel = {
        .gpio_num = pinVoltageAdjust,
        .speed_mode = LEDC_MODE,
        .channel = LEDC_CHANNEL_VADJ,
        .intr_type = LEDC_INTR_DISABLE,
        .timer_sel = LEDC_TIMER_VADJ,
        .duty = 0,
        .hpoint = 0};
    ledc_channel_config(&vadj_channel);

    // Rail read-back on ADC1 (ADC2 is unusable while WiFi is up). 11 dB covers
    // the divider's output across the whole rail range on the S3.
    analogSetPinAttenuation(pinMotorRailSense, ADC_11db);

    // Start at the minimum rail (safe) before the buck is enabled.
    setMotorRailVolts(railLoV());
    DEBUG_IO("voltage control ready (V_ADJ IO%d, EN IO%d, sense IO%d) - buck OFF, V=min (%.2f V, %s)",
             pinVoltageAdjust, pinBuckEnable, pinMotorRailSense, lastRailCmdV,
             railFitValid ? "board fit" : "nominal model");
}

void enableBuck()
{
    if (buckEnabled) return;
    setMotorRailVolts(railLoV());      // guarantee a safe (low) rail first
    digitalWrite(pinBuckEnable, HIGH); // EN_ADJ HIGH = enable
    buckEnabled = true;
    DEBUG_IO("buck enabled (IO%d HIGH)", pinBuckEnable);
}

void disableBuck()
{
    digitalWrite(pinBuckEnable, LOW);
    buckEnabled = false;
    DEBUG_IO("buck disabled (IO%d LOW)", pinBuckEnable);
}

// ===== Motor-rail read-back (V_MOT_SENSE) =====
// eFuse-calibrated millivolt read, averaged; C39 (100 nF) at the pin keeps the
// SAR's sampling kick out of the reading.
static float readRailAveraged(int samples)
{
    uint32_t sumMv = 0;
    for (int i = 0; i < samples; i++)
        sumMv += analogReadMilliVolts(pinMotorRailSense);
    const float pinV = (float)sumMv / (float)samples / 1000.0f;
    return pinV * (RAIL_SENSE_R_TOP_K + RAIL_SENSE_R_BOT_K) / RAIL_SENSE_R_BOT_K;
}

float readMotorRailVolts()
{
    return readRailAveraged(8);
}

void updateMotorRail()
{
    const float v = readMotorRailVolts();
    motorRailV += 0.3f * (v - motorRailV); // light EMA for a steady UI read-out
}

// Rail more than 0.8 V under its command: the supply is too low to reach it (buck
// in dropout) or the motor is overloading the rail. Only meaningful once the
// Test Board has proven the read-back.
bool railLimited()
{
    return railFitValid && buckEnabled && (lastRailCmdV - motorRailV) > 0.8f;
}

// ===== Test Board =====
// Steps the rail through three ascending targets with the motor PWM held at 0, and
// reads each back on V_MOT_SENSE. Proves the V_ADJ injection and the sense divider
// in one go, and fits this board's own duty->volts line (resistor / Vref / 3V3
// tolerances) so later rail commands land on the volts asked for.

// Wait for the rail to settle near a step, then return an averaged reading.
// Settled = moved < 20 mV across the last 250 ms. Going UP the buck drives the
// rail quickly; coming DOWN with no motor load only the 49k divider discharges
// the bulk capacitance on the rail, so the first step gets a longer timeout.
static float settleRail(uint32_t maxMs, bool &settled)
{
    const uint32_t SAMPLE_MS = 50;
    const uint8_t WINDOW = 5; // 5 x 50 ms = 250 ms
    float hist[WINDOW] = {0};
    uint8_t n = 0;

    vTaskDelay(pdMS_TO_TICKS(150));
    const uint32_t start = millis();
    settled = false;
    while ((millis() - start) < maxMs)
    {
        const float v = readRailAveraged(8);
        if (n >= WINDOW && fabsf(v - hist[n % WINDOW]) < 0.02f)
        {
            settled = true;
            break;
        }
        hist[n % WINDOW] = v;
        n++;
        vTaskDelay(pdMS_TO_TICKS(SAMPLE_MS));
    }
    return readRailAveraged(32);
}

static void boardTestTask(void *)
{
    DEBUG_IO("board test: start");

    // Motor stays still for the whole test (the rail alone doesn't move the needle).
    setMotorDutyRaw(0);
    if (!buckEnabled) enableBuck();

    float duty[BOARD_TEST_POINTS];
    bool used[BOARD_TEST_POINTS];
    for (uint8_t i = 0; i < BOARD_TEST_POINTS; i++)
    {
        // Drive by the NOMINAL model: we're measuring the raw relationship.
        duty[i] = vadjDutyForVolts(boardTestTargetV[i], false);
        writeVadjDuty(duty[i]);
        bool settled = false;
        boardTestMeasV[i] = settleRail(i == 0 ? 6000 : 2000, settled);
        // A first step that never settled is still discharging from a higher rail:
        // keep the reading for display but leave it out of the fit.
        used[i] = settled || i > 0;
        DEBUG_IO("board test: step %u target=%.2f V duty=%.3f -> %.2f V%s", i,
                 boardTestTargetV[i], duty[i], boardTestMeasV[i], settled ? "" : " (not settled)");
    }

    // Least-squares line through the usable points: V = v0 + k * duty.
    float sx = 0, sy = 0, sxx = 0, sxy = 0, vMax = 0;
    uint8_t n = 0, first = BOARD_TEST_POINTS, last = 0;
    for (uint8_t i = 0; i < BOARD_TEST_POINTS; i++)
    {
        if (boardTestMeasV[i] > vMax) vMax = boardTestMeasV[i];
        if (!used[i]) continue;
        sx += duty[i]; sy += boardTestMeasV[i];
        sxx += duty[i] * duty[i]; sxy += duty[i] * boardTestMeasV[i];
        if (i < first) first = i;
        last = i;
        n++;
    }
    const float den = (float)n * sxx - sx * sx;
    const float k = (n >= 2 && fabsf(den) > 1e-6f) ? ((float)n * sxy - sx * sy) / den : 0.0f;
    const float v0 = (n >= 1) ? (sy - k * sx) / (float)n : 0.0f;

    const float expectedRise = boardTestTargetV[last] - boardTestTargetV[first];
    const float measuredRise = boardTestMeasV[last] - boardTestMeasV[first];
    float worstErr = 0.0f;
    for (uint8_t i = 0; i < BOARD_TEST_POINTS; i++)
    {
        if (!used[i]) continue;
        const float e = fabsf(boardTestMeasV[i] - boardTestTargetV[i]);
        if (e > worstErr) worstErr = e;
    }

    uint8_t code;
    if (vMax < 0.5f)
        code = BT_NO_SENSE;
    else if (n < 2 || measuredRise < 0.4f * expectedRise)
        code = BT_NO_RESPONSE;
    else if (worstErr > 1.5f || k > -6.0f || k < -16.0f)
        code = BT_OUT_OF_RANGE;
    else
        code = BT_PASS;

    boardTestCode = code;
    railFitValid = (code == BT_PASS);
    if (railFitValid)
    {
        railFitV0 = v0;
        railFitSlope = k;
    }
    else
    {
        railFitV0 = RAIL_MODEL_V0;
        railFitSlope = RAIL_MODEL_SLOPE;
    }
    motorRailV = boardTestMeasV[BOARD_TEST_POINTS - 1];
    DEBUG_IO("board test: %s (fit V0=%.2f k=%.3f, worst err %.2f V)",
             boardTestText(code), v0, k, worstErr);

    // Hand the rail back exactly as boot leaves it; the speed task takes over.
    if (voltageControlEnable)
        applyMotorDrive(0.0f);
    else
        setMotorRailVolts(RAIL_V_LEGACY);
    boardTestActive = false; // results are persisted by the periodic writeEEP
    vTaskDelete(NULL);
}

bool startBoardTest()
{
    if (boardTestActive) return false;
    boardTestActive = true; // the speed task yields the motor + rail from here
    if (xTaskCreatePinnedToCore(boardTestTask, "boardTest", 4096, NULL,
                                tskIDLE_PRIORITY + 1, NULL, 1) != pdPASS)
    {
        boardTestActive = false;
        return false;
    }
    return true;
}

const char *boardTestText(uint8_t code)
{
    switch (code)
    {
    case BT_PASS:         return "Pass: voltage injection and rail sense working";
    case BT_NO_SENSE:     return "Fail: no rail voltage read back (sense divider open, or buck not running)";
    case BT_NO_RESPONSE:  return "Fail: rail does not follow V_ADJ (injection path open?)";
    case BT_OUT_OF_RANGE: return "Fail: rail responds but is off the expected voltages (check FB resistors / supply >= 12 V)";
    default:              return "Not run";
    }
}
#endif // SPP_HAS_VOLTAGE_CTRL
