adamforbes92/speedPulserPro/PlatformIO/include/SpeedPulserPro_globals.h

#ifndef GLOBALS_H
#define GLOBALS_H

#include "Arduino.h"
#include "driver/ledc.h"
#include "soc/soc_caps.h"
#include "SpeedPulserPro_board.h" // SPP_BOARD_* / SPP_HAS_* (self-contained, safe to include first)
#include <RunningMedian.h>
#include <Preferences.h>
#include <WiFi.h>
#include <ESPmDNS.h>
#include <TinyGPSPlus.h>
#include <SoftwareSerial.h>
#include <ESPAsyncWebServer.h>
#include <driver/twai.h>

// Note: config.h is NOT included here to avoid circular includes
// config.h includes this file (globals.h), so we can't include it back
// config.h must be included BEFORE globals.h in translation units

// ============================================================================
// Global Object Declarations
// ============================================================================
// LEDC PWM Control
#define LEDC_TIMER LEDC_TIMER_0
// The classic ESP32 has a high-speed LEDC timer group; the S3 only has the
// low-speed group, so the mode follows the chip's capabilities. (The RPM output
// is a GPTimer-toggled pin on both boards, so it never touches LEDC.)
#if SOC_LEDC_SUPPORT_HS_MODE
#define LEDC_MODE LEDC_HIGH_SPEED_MODE
#else
#define LEDC_MODE LEDC_LOW_SPEED_MODE
#endif
#define LEDC_OUTPUT_CHANNEL LEDC_CHANNEL_0
#define LEDC_RESOLUTION LEDC_TIMER_10_BIT
#define LEDC_FREQUENCY (10000)
#define SPEED_OFFSET_CURVE_POINTS 5
extern RunningMedian samples;
extern RunningMedian samplesRPM;
#if SPP_HAS_VR
extern RunningMedian samplesVR;
#endif
extern HardwareSerial ss;
extern TinyGPSPlus gps;
extern Preferences pref;
extern AsyncWebServer server;
extern hw_timer_t *timer0;
extern TaskHandle_t taskCANRxHandle;

// ============================================================================
// RPM and PWM Variables
// ============================================================================
extern bool rpmTrigger;
extern long frequencyRPM;
extern long pwmFrequency;
extern long dutyCycle;
extern int pwmResolution;
extern unsigned long dutyCycleIncoming;
extern float rpmInputHz; // engine RPM input frequency (Hz), windowed average
#if SPP_HAS_VR
extern volatile unsigned long dutyCycleIncomingVR; // VR input frequency (Hz), written in ISR
#endif
extern uint16_t appliedDutyCycle; // last duty value written to the motor (for the live curve marker)

// Motor direction: false = normal (pinMotorDirection LOW), true = reverse (HIGH)
extern bool reverseDirection;
void applyDirection(); // drive pinMotorDirection from reverseDirection (io.cpp)

#if SPP_HAS_SPEED_BIAS
// Speed-input bias (S3 board): the old PullDown/Up header is now two GPIO-driven
// switches. 0 = none (input floats — fine for push-pull sources such as Can2Cluster),
// 1 = 4.7k pull-up to VCC/12 V (open-collector hall sensors), 2 = 4.7k pull-down to GND.
// Only ever ONE switch is driven on; both on would put ~1.3 mA straight through R19+R46.
#define SPEED_BIAS_NONE      0
#define SPEED_BIAS_PULL_UP   1
#define SPEED_BIAS_PULL_DOWN 2
extern uint8_t speedInputBias;
void applySpeedInputBias(); // drive pinSpeedPullUp / pinSpeedPullDown from speedInputBias (io.cpp)
#endif

// ============================================================================
// Closed-Loop Motor Feedback (PID)
// ============================================================================
extern volatile uint32_t feedbackCount; // motor tacho pulses — incremented in ISR
extern bool feedbackEnable;             // enable PID duty trim from the motor tacho
extern float pidKp;                     // PID proportional gain
extern float pidKi;                     // PID integral gain
extern float pidKd;                     // PID derivative gain
extern float feedbackDeadband;          // PID deadband (Hz); within this error P/D are silenced (integral still trims). 0 = off
extern uint16_t feedbackMaxFreq;        // tacho Hz that corresponds to maxSpeed (bench-baked)
extern uint16_t feedbackMinSpeed;       // kph; below this target the loop runs open-loop (anti-hunt)
extern uint16_t measuredSpeed;          // measured motor speed from tacho (kph, UI/status)
extern int16_t pidCorrection;           // current PID duty correction (UI/status)
extern float measuredFreqHz;            // EMA-smoothed tacho frequency (Hz)
extern float measuredFreqRawHz;         // un-smoothed tacho frequency (Hz), diagnostic
extern bool feedbackAvailable;          // true once a real tacho signal has been seen this session
extern bool feedbackMissing;            // true when the motor runs but no feedback signal is present (legacy PCB)

// ============================================================================
// Speed Variables
// ============================================================================
extern uint16_t vehicleRPMCAN;
extern uint16_t vehicleRPM;
extern uint16_t vehicleRPMHall;
extern uint16_t calcSpeed;
extern uint16_t vehicleSpeed;
extern uint16_t vehicleSpeedHall;
extern uint16_t vehicleSpeedCAN;
extern uint16_t vehicleSpeedGPS;
extern uint16_t hallSpeed;
#if SPP_HAS_VR
extern uint16_t vehicleSpeedVR;
extern uint16_t vrSpeed;
#endif
extern uint16_t ecuSpeed;
extern uint16_t dsgSpeed;
extern uint16_t gpsSpeed;
extern uint16_t absSpeed;
extern uint16_t udsSpeed;
extern uint16_t tp20Speed;

// ============================================================================
// Motor Performance and Limits
// ============================================================================
extern uint16_t motorPerformance[385];
extern bool updateMotorPerformance;
extern uint8_t motorPerformanceVal;
extern uint16_t maxFreqHall;
extern uint16_t maxFreqCAN;
#if SPP_HAS_VR
extern uint16_t maxFreqVR;
#endif
extern uint16_t maxSpeed;
extern uint16_t maxRPM;
extern uint16_t clusterRPMLimit;

// ============================================================================
// Speed Offset and Calibration
// ============================================================================
extern uint8_t speedOffset;
extern bool speedOffsetPositive;
extern bool useGlobalSpeedOffset;
extern bool useSpeedOffsetCurve;
extern int16_t speedOffsetCurveOffsets[SPEED_OFFSET_CURVE_POINTS];
extern int16_t currentSpeedOffset;
extern float stepRPM;
extern float stepSpeed;
extern uint8_t averageFilterHall;
extern uint8_t averageFilterRPM;
#if SPP_HAS_VR
extern uint8_t averageFilterVR;
#endif
extern float filteredRPMHz; // median-filtered RPM input (Hz), passed straight to the RPM output

// ============================================================================
// Test Variables
// ============================================================================
extern bool testSpeedo;
extern bool testRPM;
extern bool testCal;
extern long tempSpeed;
extern long tempRPM;
extern long tempDutyCycle;
extern bool tempNeedleSweep;

// ============================================================================
// Configuration Variables
// ============================================================================
extern bool hasNeedleSweep;
extern bool linearSpeedSweep;
extern bool coilType;
extern bool convertToMPH;
extern bool broadcastSpeedEnabled;
extern uint32_t broadcastSpeedID;
extern uint8_t broadcastSpeedDLC;
extern uint8_t broadcastSpeedLowByte;
extern uint8_t broadcastSpeedHighByte;
extern bool broadcastSpeedLittleEndian;
extern float broadcastSpeedScale;
extern int16_t broadcastSpeedOffset;
extern uint8_t broadcastSpeedData[8];
extern uint16_t broadcastSpeedValue;
extern uint8_t sweepSpeed;
extern uint8_t speedType;

// ============================================================================
// Speed Input Selection
// ============================================================================
extern bool useHall;                      // true = Hall sensor
#if SPP_HAS_VR
extern bool useVR;                        // true = variable-reluctance (VR) sensor (S3 board only)
#endif
extern bool useDSG;                       // true = DSG speed
extern bool useGPS;                       // true = GPS speed
extern bool useABS;                       // true = ABS speed
extern bool useECU;                       // true = ECU speed
extern bool useUDS;                       // true = UDS speed
extern bool useTP20;                      // true = TP2.0 speed
extern bool useAftermarket;               // speed input: custom CAN (aftermarket)
extern uint32_t aftermarketSpeedID;       // CAN ID to listen to
extern uint8_t aftermarketSpeedLowByte;   // byte index holding speed LSB
extern uint8_t aftermarketSpeedHighByte;  // byte index holding speed MSB
extern bool aftermarketSpeedLittleEndian; // true = LSB at lowByte index
extern float aftermarketSpeedScale;       // scale applied to raw value
extern int16_t aftermarketSpeedOffset;    // offset applied after scale
extern uint16_t aftermarketSpeed;         // parsed speed from aftermarket CAN frame

// RPM Input Selection
extern bool useRPMHall;
extern bool useRPMCAN;

// ============================================================================
// DSG Variables
// ============================================================================
extern uint8_t gear;
extern uint8_t lever;
extern uint8_t gear_raw;
extern uint8_t lever_raw;
extern float dsgGearRatio[7];  // adjustable gear ratios, index 1..6 (DQ250 defaults)
extern float dsgFinalDrive14;  // final drive for gears 1-4
extern float dsgFinalDrive56;  // final drive for gears 5-6
extern float dsgTireCirc;      // tire circumference in metres

// ============================================================================
// Vehicle Status Variables
// ============================================================================
extern bool vehicleEML;
extern bool vehicleEPC;
extern bool vehicleReverse;
extern bool vehiclePark;

// ============================================================================
// Timing Variables
// ============================================================================
extern uint32_t lastMillis;
extern uint32_t lastMillis2;
extern uint32_t lastCAN;
extern unsigned long lastPulse;
extern unsigned long lastPulseRPM;
#if SPP_HAS_VR
extern volatile unsigned long lastPulseVR;
#endif

// ============================================================================
// SavvyCAN / Analyser Variables
// ============================================================================
extern bool analyzerMode;        // WiFi GVRET/SLCAN (TCP port 23)
extern bool analyzerSerial;      // Serial GVRET (SavvyCAN over USB, 1 Mbaud)
extern uint8_t analyzerProtocol; // ANALYZER_PROTOCOL_GVRET or ANALYZER_PROTOCOL_LAWICEL

// ============================================================================
// System Status Variables
// ============================================================================
extern bool hasError;
extern bool hasCAN;
extern bool hasGPS;
extern bool gpsUnavailable;
extern bool ledOnboard;
extern int ledCounter;
extern int rawCount;
extern int rawCountRPM;

#endif // GLOBALS_H
