adamforbes92/speedPulserPro/Code/SpeedPulserPro_wifi.ino

void setupUI() {
  //Turn off verbose debugging
  ESPUI.setVerbosity(Verbosity::Quiet);
  ESPUI.sliderContinuous = true;

  // create basic tab
  auto tabBasic = ESPUI.addControl(Tab, "", "Basic");
  ESPUI.addControl(Separator, "Needle Sweep", "", Dark, tabBasic);
  bool_NeedleSweep = ESPUI.addControl(Switcher, "Needle Sweep", String(hasNeedleSweep), Dark, tabBasic, generalCallback);
  int16_sweepSpeed = ESPUI.addControl(Slider, "Rate of Change (ms)", String(sweepSpeed), Dark, tabBasic, generalCallback);
  ESPUI.addControl(Max, "", "50", Dark, int16_sweepSpeed);
  int16_stepRPM = ESPUI.addControl(Slider, "Rate RPM", String(stepRPM), Dark, tabBasic, generalCallback);
  ESPUI.addControl(Max, "", "100", Dark, int16_stepRPM);
  int16_stepSpeed = ESPUI.addControl(Slider, "Rate Speed", String(stepSpeed), Dark, tabBasic, generalCallback);
  ESPUI.addControl(Max, "", "100", Dark, int16_stepSpeed);
  ESPUI.addControl(Button, "Test Needle Sweep", "Test", Dark, tabBasic, extendedCallback, (void *)11);

  // create advanced speed tab
  auto tabAdvancedSpeed = ESPUI.addControl(Tab, "", "Speed");
  ESPUI.addControl(Separator, "Calibration:", "", Dark, tabAdvancedSpeed);
  int16_calNumber = ESPUI.addControl(Select, "Calibration", "", Dark, tabAdvancedSpeed, generalCallback);
  ESPUI.addControl(Option, "VW - 120mph; Martin Springell", "VW120Martin", Dark, int16_calNumber);   // Martin's 120mph speed calibration
  ESPUI.addControl(Option, "VW - 120mph; Forbes-Automotive", "VW120Forbes", Dark, int16_calNumber);  // Forbes's 120mph speed calibration
  ESPUI.addControl(Option, "VW - 140mph; Forbes-Automotive", "VW140Forbes", Dark, int16_calNumber);
  ESPUI.addControl(Option, "VW - 160mph; Forbes-Automotive", "VW160Forbes", Dark, int16_calNumber);
  ESPUI.addControl(Option, "VW - 300kph; Forbes-Automotive", "VW300Forbes", Dark, int16_calNumber);
  ESPUI.addControl(Option, "Ford - 120mph_1; Forbes-Automotive", "Ford120Forbes1", Dark, int16_calNumber);
  ESPUI.addControl(Option, "Ford - 120mph_2; Forbes-Automotive", "Ford120Forbes2", Dark, int16_calNumber);
  ESPUI.addControl(Option, "FIAT - 40-160mph; Forbes-Automotive", "FIAT160Forbes1", Dark, int16_calNumber);
  ESPUI.addControl(Option, "FIAT - 20-110mph; Forbes-Automotive", "FIAT160Forbes2", Dark, int16_calNumber);
  ESPUI.addControl(Option, "Merc - 120mph; Forbes-Automotive", "Merc120Forbes", Dark, int16_calNumber);
  ESPUI.addControl(Option, "Smiths - 70mph; Forbes-Automotive", "Smiths70Forbes", Dark, int16_calNumber);
  ESPUI.addControl(Option, "Smiths - 90mph; Forbes-Automotive", "Smiths90Forbes", Dark, int16_calNumber);  // purely for future cals so WiFi is already pre-defined
  ESPUI.addControl(Option, "FutureCal2; Forbes-Automotive", "FutureCal2", Dark, int16_calNumber);          // purely for future cals so WiFi is already pre-defined
  ESPUI.addControl(Option, "FutureCal3; Forbes-Automotive", "FutureCal3", Dark, int16_calNumber);          // purely for future cals so WiFi is already pre-defined

  ESPUI.addControl(Separator, "Speed Input:", "", Dark, tabAdvancedSpeed);
  int16_speedType = ESPUI.addControl(Select, "Speed Type", "", Dark, tabAdvancedSpeed, generalCallback);
  ESPUI.addControl(Option, "Hall Sensor", "Hall", Dark, int16_speedType);
  ESPUI.addControl(Option, "ECU (via. CAN)", "ECU", Dark, int16_speedType);
  ESPUI.addControl(Option, "ABS (via. CAN)", "ABS", Dark, int16_speedType);
  ESPUI.addControl(Option, "DSG (via. CAN)", "DSG", Dark, int16_speedType);
  ESPUI.addControl(Option, "GPS Module", "GPS", Dark, int16_speedType);

  ESPUI.addControl(Separator, "Testing", "", Dark, tabAdvancedSpeed);
  bool_testSpeedo = ESPUI.addControl(Switcher, "Test Speedo", "", Dark, tabAdvancedSpeed, generalCallback);
  int16_tempSpeed = ESPUI.addControl(Slider, "Go to Speed", String(tempSpeed), Dark, tabAdvancedSpeed, generalCallback);
  ESPUI.addControl(Max, "", "400", Dark, int16_tempSpeed);

  ESPUI.addControl(Separator, "Speed Offsets", "", Dark, tabAdvancedSpeed);
  bool_positiveOffset = ESPUI.addControl(Switcher, "Positive Offset", String(speedOffsetPositive), Dark, tabAdvancedSpeed, generalCallback);
  int16_speedOffset = ESPUI.addControl(Slider, "Speed Offset", String(speedOffset), Dark, tabAdvancedSpeed, generalCallback);
  ESPUI.addControl(Max, "", "50", Dark, int16_speedOffset);

  ESPUI.addControl(Separator, "Speed Limits:", "", Dark, tabAdvancedSpeed);
  int16_maxSpeed = ESPUI.addControl(Slider, "Maximum Speed", String(maxSpeed), Dark, tabAdvancedSpeed, generalCallback);
  ESPUI.addControl(Max, "", "400", Dark, int16_maxSpeed);
  ESPUI.addControl(Button, "Reset", "Reset", Dark, tabAdvancedSpeed, extendedCallback, (void *)12);

  ESPUI.addControl(Separator, "Hall Incoming Freq:", "", Dark, tabAdvancedSpeed);
  int16_maxHall = ESPUI.addControl(Slider, "Maximum Hall", String(maxFreqHall), Dark, tabAdvancedSpeed, generalCallback);
  ESPUI.addControl(Max, "", "400", Dark, int16_maxHall);
  ESPUI.addControl(Button, "Reset", "Reset", Dark, tabAdvancedSpeed, extendedCallback, (void *)13);

  ESPUI.addControl(Separator, "CAN Incoming Freq:", "", Dark, tabAdvancedSpeed);
  int16_maxCAN = ESPUI.addControl(Slider, "Maximum CAN", String(maxFreqCAN), Dark, tabAdvancedSpeed, generalCallback);
  ESPUI.addControl(Max, "", "400", Dark, int16_maxCAN);
  ESPUI.addControl(Button, "Reset", "Reset", Dark, tabAdvancedSpeed, extendedCallback, (void *)14);

  // create advanced RPM tab
  auto tabAdvancedRPM = ESPUI.addControl(Tab, "", "RPM");
  ESPUI.addControl(Separator, "Testing", "", Dark, tabAdvancedRPM);
  bool_testRPM = ESPUI.addControl(Switcher, "Test RPM", "", Dark, tabAdvancedRPM, generalCallback);
  int16_tempRPM = ESPUI.addControl(Slider, "Go to RPM", String(tempRPM), Dark, tabAdvancedRPM, generalCallback);
  ESPUI.addControl(Max, "", "9000", Dark, int16_tempRPM);

  ESPUI.addControl(Separator, "Cluster Limits:", "", Dark, tabAdvancedRPM);
  int16_clusterRPM = ESPUI.addControl(Slider, "Maximum RPM", String(clusterRPMLimit), Dark, tabAdvancedRPM, generalCallback);
  ESPUI.addControl(Max, "", "9000", Dark, int16_clusterRPM);
  ESPUI.addControl(Button, "Reset", "Reset", Dark, tabAdvancedRPM, extendedCallback, (void *)15);

  ESPUI.addControl(Separator, "RPM Scaling:", "", Dark, tabAdvancedRPM);
  int16_RPMScaling = ESPUI.addControl(Slider, "RPM Scaling", String(maxRPM), Dark, tabAdvancedRPM, generalCallback);
  ESPUI.addControl(Max, "", "500", Dark, int16_RPMScaling);
  ESPUI.addControl(Button, "Reset", "Reset", Dark, tabAdvancedRPM, extendedCallback, (void *)16);

  // create advanced speed tab
  auto tabIO = ESPUI.addControl(Tab, "", "IO");
  ESPUI.addControl(Separator, "Incoming Data", "", Dark, tabIO);
  ESPUI.addControl(Separator, "CAN Available:", "", Dark, tabIO);
  label_hasCAN = ESPUI.addControl(Label, "", "0", Dark, tabIO, generalCallback);

  ESPUI.addControl(Separator, "GPS Available:", "", Dark, tabIO);
  label_hasGPS = ESPUI.addControl(Label, "", "0", Dark, tabIO, generalCallback);

  ESPUI.addControl(Separator, "Incoming RPM (CAN):", "", Dark, tabIO);
  label_RPMCAN = ESPUI.addControl(Label, "", "0", Dark, tabIO, generalCallback);
  ESPUI.addControl(Separator, "Incoming RPM (Hall Type):", "", Dark, tabIO);
  label_RPMHall = ESPUI.addControl(Label, "", "0", Dark, tabIO, generalCallback);

  ESPUI.addControl(Separator, "Incoming Speed:", "", Dark, tabIO);
  label_speedHall = ESPUI.addControl(Label, "Hall Speed:", "0", Dark, tabIO, generalCallback);
  label_speedECU = ESPUI.addControl(Label, "ECU Speed:", "0", Dark, tabIO, generalCallback);
  label_speedDSG = ESPUI.addControl(Label, "DSG Speed:", "0", Dark, tabIO, generalCallback);
  label_speedABS = ESPUI.addControl(Label, "ABS Speed:", "0", Dark, tabIO, generalCallback);
  label_speedGPS = ESPUI.addControl(Label, "GPS Speed:", "0", Dark, tabIO, generalCallback);

  // create calibration tab:
  auto tabCal = ESPUI.addControl(Tab, "", "Calibration");
  ESPUI.addControl(Separator, "Calibration:", "", Dark, tabCal);
  bool_testCal = ESPUI.addControl(Switcher, "Enable Calibration", "", Dark, tabCal, generalCallback);
  ESPUI.addControl(Button, "Previous Duty", "Previous", Dark, tabCal, extendedCallback, (void *)14);
  ESPUI.addControl(Button, "Next Duty", "Next", Dark, tabCal, extendedCallback, (void *)15);
  label_currentPWM = ESPUI.addControl(Label, "", "0", Dark, tabCal, generalCallback);


  //Finally, start up the UI.
  //This should only be called once we are connected to WiFi.
  ESPUI.begin(wifiHostName);
}

void updateCallback(Control *sender, int type) {
  updates = (sender->value.toInt() > 0);
}

void getTimeCallback(Control *sender, int type) {
  if (type == B_UP) {
    ESPUI.updateTime(mainTime);
  }
}

void graphAddCallback(Control *sender, int type) {
  if (type == B_UP) {
    ESPUI.addGraphPoint(graph, random(1, 50));
  }
}

void graphClearCallback(Control *sender, int type) {
  if (type == B_UP) {
    ESPUI.clearGraph(graph);
  }
}

void generalCallback(Control *sender, int type) {
#ifdef serialDebugWifi
  Serial.print("CB: id(");
  Serial.print(sender->id);
  Serial.print(") Type(");
  Serial.print(type);
  Serial.print(") '");
  Serial.print(sender->label);
  Serial.print("' = ");
  Serial.println(sender->value);
#endif

  uint8_t tempID = int(sender->id);
  switch (tempID) {
    case 3: hasNeedleSweep = sender->value.toInt(); break;
    case 4: sweepSpeed = sender->value.toInt(); break;
    case 6: stepRPM = sender->value.toInt(); break;
    case 8: stepSpeed = sender->value.toInt(); break;

    case 13:
      if (sender->value == "VW120Martin") motorPerformanceVal = 1;
      if (sender->value == "VW120Forbes") motorPerformanceVal = 2;
      if (sender->value == "VW140Forbes") motorPerformanceVal = 3;
      if (sender->value == "VW160Forbes") motorPerformanceVal = 4;
      if (sender->value == "VW300Forbes") motorPerformanceVal = 5;
      if (sender->value == "Ford120Forbes1") motorPerformanceVal = 6;
      if (sender->value == "Ford120Forbes2") motorPerformanceVal = 7;
      if (sender->value == "FIAT160Forbes1") motorPerformanceVal = 8;
      if (sender->value == "FIAT160Forbes2") motorPerformanceVal = 9;
      if (sender->value == "Merc120Forbes") motorPerformanceVal = 10;
      if (sender->value == "Smiths70Forbes") motorPerformanceVal = 11;
      if (sender->value == "Smiths90Forbes") motorPerformanceVal = 12;

      if (sender->value == "FutureCal2") motorPerformanceVal = 13;
      if (sender->value == "FutureCal3") motorPerformanceVal = 14;

      updateMotorPerformance = true;
      break;

    case 29:
      if (sender->value == "Hall") {
        useHall = true;
        useDSG = false;
        useECU = false;
        useABS = false;
        useGPS = false;
      }
      if (sender->value == "ECU") {
        useHall = false;
        useDSG = false;
        useECU = true;
        useABS = false;
        useGPS = false;
      }
      if (sender->value == "DSG") {
        useHall = false;
        useDSG = true;
        useECU = false;
        useABS = false;
        useGPS = false;
      }
      if (sender->value == "ABS") {
        useHall = false;
        useDSG = false;
        useECU = false;
        useABS = true;
        useGPS = false;
      }
      if (sender->value == "GPS") {
        useHall = false;
        useDSG = false;
        useECU = false;
        useABS = false;
        useGPS = true;
      }

    case 36: testSpeedo = sender->value.toInt(); break;
    case 37: tempSpeed = sender->value.toInt(); break;
    case 40: speedOffsetPositive = sender->value.toInt(); break;
    case 41: speedOffset = sender->value.toInt(); break;
    case 44: maxSpeed = sender->value.toInt(); break;
    case 48: maxFreqHall = sender->value.toInt(); break;

    case 52: maxFreqCAN = sender->value.toInt(); break;
    case 57: testRPM = sender->value.toInt(); break;
    case 58: tempRPM = sender->value.toInt(); break;
    case 61: clusterRPMLimit = sender->value.toInt(); break;
    case 65: maxRPM = sender->value.toInt(); break;

    case 86: testCal = sender->value.toInt(); break;
  }
}

void extendedCallback(Control *sender, int type, void *param) {
#ifdef serialDebugWifi
  Serial.print("CB: id(");
  Serial.print(sender->id);
  Serial.print(") Type(");
  Serial.print(type);
  Serial.print(") '");
  Serial.print(sender->label);
  Serial.print("' = ");
  Serial.println(sender->value);
  Serial.print("param = ");
  Serial.println((long)param);
#endif

  uint8_t tempID = int(sender->id);
  switch (tempID) {
    case 10:
      if (type == B_UP) {
        tempNeedleSweep = true;
      }
      break;
    case 46:
      if (type == B_UP) {
        maxSpeed = 200;
        ESPUI.updateSlider(int16_maxSpeed, maxSpeed);
      }
      break;
    case 50:
      if (type == B_UP) {
        maxFreqHall = 200;
        ESPUI.updateSlider(int16_maxHall, maxFreqHall);
      }
      break;
    case 54:
      if (type == B_UP) {
        maxFreqCAN = 200;
        ESPUI.updateSlider(int16_maxCAN, maxFreqCAN);
      }
      break;
    case 63:
      if (type == B_UP) {
        clusterRPMLimit = 7000;
        ESPUI.updateSlider(int16_clusterRPM, clusterRPMLimit);
      }
      break;
    case 67:
      if (type == B_UP) {
        maxRPM = 230;
        ESPUI.updateSlider(int16_RPMScaling, maxRPM);
      }
      break;


    case 87:
      if (type == B_UP) {
        tempDutyCycle = tempDutyCycle - 1;
        if (tempDutyCycle < 0) {
          tempDutyCycle = 385;
        }
      }
      break;
    case 88:
      if (type == B_UP) {
        tempDutyCycle = tempDutyCycle + 1;
        if (tempDutyCycle > 385) {
          tempDutyCycle = 0;
        }
      }
      break;
  }
}

void connectWifi() {
  int connect_timeout;

  WiFi.setHostname(wifiHostName);
  DEBUG_PRINTLN("Beginning WiFi...");
  DEBUG_PRINTLN("Creating Access Point...");
  //WiFi.setTxPower(WIFI_POWER_8_5dBm);
  WiFi.mode(WIFI_AP);
  WiFi.softAPConfig(IPAddress(192, 168, 1, 1), IPAddress(192, 168, 1, 1), IPAddress(255, 255, 255, 0));
  WiFi.softAP(wifiHostName);
}

void textCallback(Control *sender, int type) {
  //This callback is needed to handle the changed values, even though it doesn't do anything itself.
}

void randomString(char *buf, int len) {
  for (auto i = 0; i < len - 1; i++)
    buf[i] = random(0, 26) + 'A';
  buf[len - 1] = '\0';
}

void disconnectWifi() {
  DEBUG_PRINTF("Number of connections: ");
  DEBUG_PRINTLN(WiFi.softAPgetStationNum());

  if (WiFi.softAPgetStationNum() == 0) {
    DEBUG_PRINTLN("No connections, turning off");
    WiFi.disconnect(true, false);
    WiFi.mode(WIFI_OFF);
  }
}

void setupOTA() {
  updateServer.setup(ESPUI.WebServer(), "", "");

  updateServer.onUpdateBegin = [](const UpdateType type, int &result) {
    //you can force abort the update like this if you need to:
    //result = UpdateResult::UPDATE_ABORT;
    Serial.println("Update started : " + String(type));
  };
  updateServer.onUpdateEnd = [](const UpdateType type, int &result) {
    Serial.println("Update finished : " + String(type) + " result: " + String(result));
  };
}
