adamforbes92/speedPulserPro/(commit log)

2026-03-13 V1.08
    Added calibration page & releases
    [partitions.csv]
2026-06-01 V2.10
    SavvyCAN, Tara 120mph Calibration, Linearise Needle Sweep
2026-06-28 V2.50
    Added low power mode - no WiFi Clients within 1 min turns it off to save power.
2026-07-18 V2.50
    Added BMW 2002 calibration.
2026-08-09 V3.04
    Added feedback and PID control and general tidy up of the UI. Added custom calibration builder.
2026-08-09 V3.04
    Major feedback, PID, custom calibration builder and UI updates. Few cleanups along the way hence the 3.xx changes.
2026-10-12 V5.02
    Added S3 and DevKit RPM filtering
